ImperialSpaceSociety/Project-Mach-1/docs/README.md

# Project-Mach-1
# **docs - Top Level Specfications and Documents**

This is the design for the 2 stage rocket designed to pass the speed of sound. A hand drawing of the rocket is as shown:
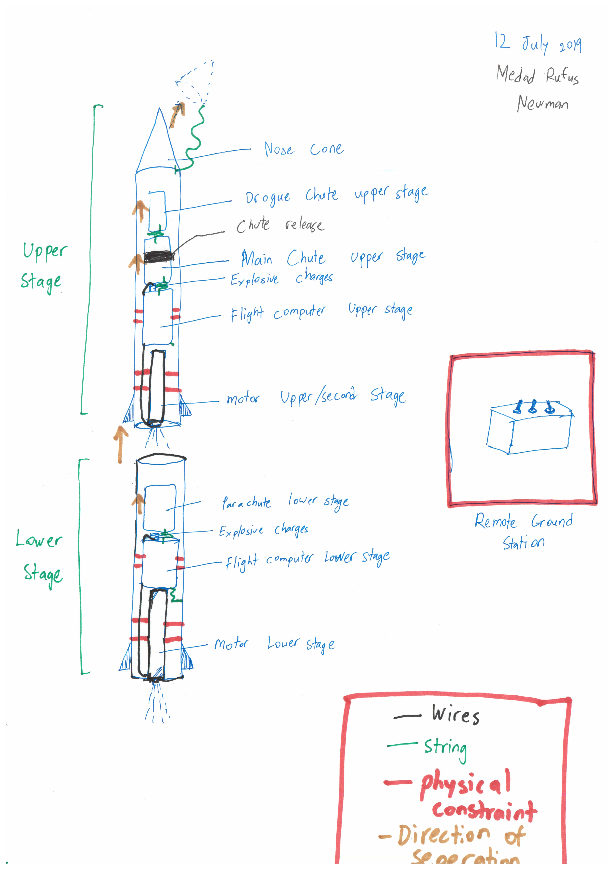
[picture p3: docs/rocket_drawing.jpg]
Hand drawing
