ImperialSpaceSociety/Project-Mach-1/Flight Computer V2.1/Gas sensors ideas.txt

https://www.sensirion.com/en/environmental-sensors/carbon-dioxide-sensors/carbon-dioxide-sensor-scd4x/
https://www.co2meter.com/collections/carbon-dioxide-sensors/products/lp8-miniature-co2-sensor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 This also works. It's very light. Has arduino stuff.
https://www.infineon.com/cms/en/product/sensor/co2-sensors/ //CO2 sensor, not sure if the 30 ppm accuracy is going to deliver meaningful data
