ImperialSpaceSociety/Project-Mach-1/Flight Computer V2.1/Pressure sensors ideas.txt

https://www.rapidonline.com/adafruit-1893-mpl3115a2-i2c-barometric-pressure-altitude-temperature-sensor-73-5402
https://www.adafruit.com/product/1603 //similar to the one above
https://www.mouser.co.uk/ProductDetail/Amphenol-All-Sensors/ELVH-030A-HNNJ-I-N2A4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
