ImperialSpaceSociety/Project-Mach-1/Flight Computer V2.1/Radio ideas.md

Ideas for radios here:

http://eggtimerrocketry.com/wp-content/uploads/2018/10/Eggfinder-Mini-Assembly-Manual-A7-Pics.pdf

use lora without datarate limitations (so not lorawan)

# SX1276/77/78/79 from Semtech

- Very common LoRA chip featured in many modules
- Link: https://www.semtech.com/products/wireless-rf/lora-core/sx1278

- Notable Features:
  - Programmable bit rate up to 300 Kbps
  - Low power consumption
  - Has Arduino libraries ready to use
  - Cheap: most modules are under 10 GBP.

  - http://en.ashining.com/

- Wide array of pre-built modules in many form factors:
  - https://item.taobao.com/item.htm?spm=a230r.1.14.61.c6207623p6iLYO&id=569473209313&ns=1&abbucket=16#detail
  - https://item.taobao.com/item.htm?spm=a230r.1.14.16.17807623d8OA8n&id=534906947976&ns=1&abbucket=16#detail
  - https://item.taobao.com/item.htm?spm=a230r.1.14.22.17807623d8OA8n&id=644570447285&ns=1&abbucket=16#detail
  - https://item.taobao.com/item.htm?spm=a230r.1.14.28.17807623d8OA8n&id=631724138123&ns=1&abbucket=16#detail
  - https://item.taobao.com/item.htm?spm=a230r.1.14.41.17807623d8OA8n&id=543372168003&ns=1&abbucket=16#detail
  - https://item.taobao.com/item.htm?spm=a230r.1.14.126.17807623d8OA8n&id=526364795844&ns=1&abbucket=16#detail

# HopeRF RFM95/98

- Link: https://www.hoperf.com/modules/lora/RFM95.html

# XBEE®868LP
- https://docs.rs-online.com/d0cc/0900766b8148f252.pdf

# XBP9B-XCST-021
- https://www.mouser.co.uk/ProductDetail/DIGI/XBP9B-XCST-021?qs=bzXpJip73srHwKnGuHrX3A%3D%3D
