ImperialSpaceSociety/Project-Mach-1/Flight Computer V2.1/Radios we have.md

- Ground station:
	https://eu.mouser.com/ProductDetail/DIGI/XBP9B-DPST-041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
	
	Datasheet: https://hub.digi.com/support/products/digi-xbee/digi-xbee-pro-900hp/
	
- Rocket:
	https://eu.mouser.com/ProductDetail/DIGI/XBP9XT-DMRS-001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
	
	Datasheet: https://www.digi.com/resources/documentation/Digidocs/90001476/Default.htm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
