ImperialSpaceSociety/Project-Mach-1/Flight Computer V2.1/XBEE comparison.PNG

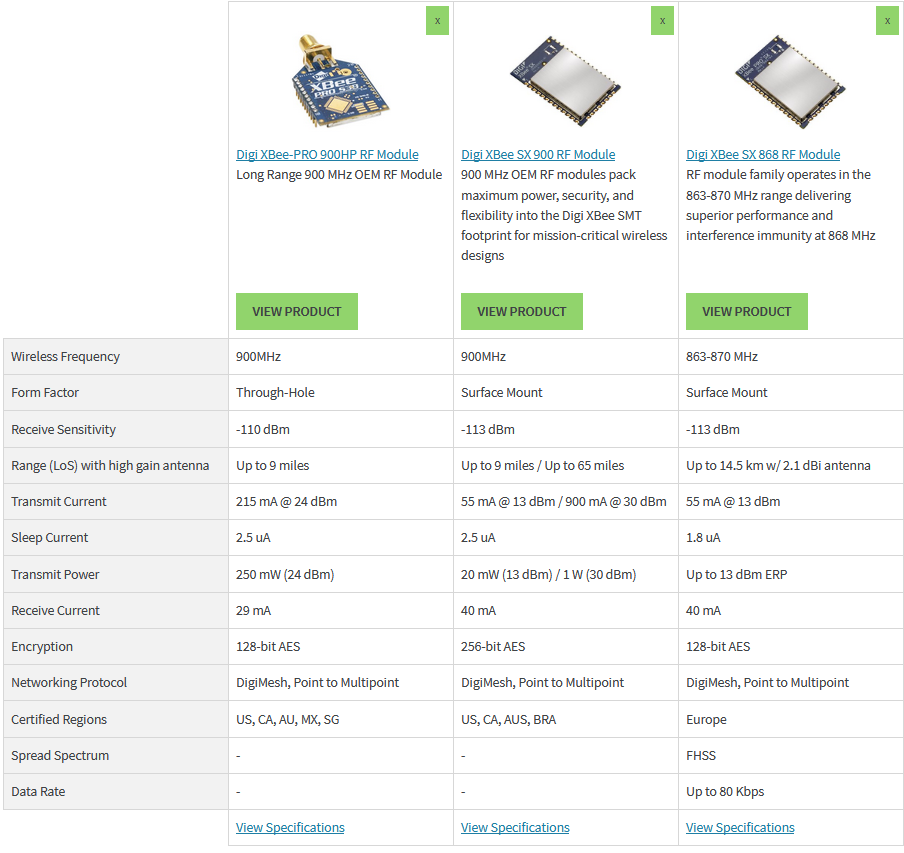
Flight Computer V2.1/XBEE comparison.PNG
