ImperialSpaceSociety/Project-Mach-1/Hardware/circuit board design v1.1/BOM v1.1.xlsx

Bill of materials for Project Mach 1, the high powered rocketry project at the Imperial College Space Society. The plan is to built 5 identical flight computers that can be used in a single stage rocket or a multi stage setup.
The flight computer has a size of
Components that go on the PCB
Reference | Value | Footprint | Datasheet | Unit cost | Purchase Link | Quantity per flight computer
ANT1 | Yageo434 | flight-computer:Yageo434 | https://www.mouser.co.uk/datasheet/2/447/An_SMD_UHF_433_1204_0-595178.pdf | £1.33 | https://www.mouser.co.uk/ProductDetail/Yageo/ANT1204F002R0433A | 1
BZ1 | Buzzer | Buzzer_Beeper:Buzzer_12x9.5RM7.6 | https://docs-emea.rs-online.com/webdocs/1581/0900766b815810c5.pdf | £1.05 | https://uk.rs-online.com/web/p/magnetic-buzzer-components/6173081/?searchTerm=6173081 | 1
> C8, C20, C34 | 10nF | Capacitor_SMD:C_0402_1005Metric | ~ |  |  | 3
C9 | 270pF | Capacitor_SMD:C_0402_1005Metric | ~ |  |  | 1
C19 | 270pf | Capacitor_SMD:C_0402_1005Metric | ~ |  |  | 1
C21 | 33nF | Capacitor_SMD:C_0402_1005Metric | ~ |  |  | 1
> C22, C35, C36, C90 | 1uF | Capacitor_SMD:C_0603_1608Metric | ~ |  |  | 4
> C30, C77 | 220nF | Capacitor_SMD:C_0603_1608Metric | ~ |  |  | 2
> C1, C2, C5, C12, C32, C92 | 10uF | Capacitor_SMD:C_0603_1608Metric | ~ |  |  | 6
> C3, C4, C6, C7, C11, C23, C28, C29, C31, C33, C89, C91, C93 | 100nF | Capacitor_SMD:C_0603_1608Metric | ~ |  |  | 13
> C86, C88 | 15pF | Capacitor_SMD:C_0402_1005Metric | ~ |  |  | 2
D1 | RED_LED | LED_SMD:LED_0603_1608Metric | ~ |  |  | 1
D2 | BLUE_LED | LED_SMD:LED_0603_1608Metric | ~ |  |  | 1
D3 | DFLS130L | Diode_SMD:D_PowerDI-123 | https://www.diodes.com/assets/Datasheets/ds30492.pdf | £0.45 | https://www.mouser.co.uk/ProductDetail/Diodes-Incorporated/DFLS130LQ-7 | 1
> H1-H4 | MountingHole_Pad | MountingHole:MountingHole_3.2mm_M3_Pad | ~ |  |  | 4
J1 | Conn_01x05 | Connector_PinHeader_2.54mm:PinHeader_1x05_P2.54mm_Vertical | ~ |  |  | 1
J2 | USB_B_Micro | flight-computer:USB_Micro-B_Molex-105017-0001 | https://www.molex.com/webdocs/datasheets/pdf/en-us/1050170001_IO_CONNECTORS.pdf | £0.64 | https://www.mouser.co.uk/ProductDetail/Molex/105017-0001 | 1
> J3, J5 | Screw_Terminal_01x04 | flight-computer:TerminalBlock_TE_282834-4_1x04_P2.54mm_Horizontal | ~ |  | https://www.mouser.co.uk/ProductDetail/TE-Connectivity/282834-4?qs=A%252Bip%252BNCYi6Pqom9P%2FaHyRQ== | 2
J4 | Conn_01x02 | Connector_JST:JST_PH_B2B-PH-K_1x02_P2.00mm_Vertical | https://docs-emea.rs-online.com/webdocs/1347/0900766b81347511.pdf | £0.38 | https://uk.rs-online.com/web/p/pcb-headers/8201422/ | 1
> J6, J7 | Conn_Coaxial | Connector_Coaxial:U.FL_Hirose_U.FL-R-SMT-1_Vertical | https://www.mouser.co.uk/datasheet/2/185/U.FL_catalog-939761.pdf | £1.05 | https://www.mouser.co.uk/ProductDetail/Hirose-Connector/UFL-R-SMT01?qs=Ux3WWAnHpjDV3tCCbDi65g== | 2
L1 | L_Core_Ferrite | Inductor_SMD:L_0603_1608Metric | ~ |  |  | 1
L2 | 27nH | Resistor_SMD:R_0402_1005Metric | ~ |  |  | 1
L3 | 0R | Inductor_SMD:L_0402_1005Metric | ~ |  |  | 1
L8 | 220nH | Inductor_SMD:L_0603_1608Metric | ~ |  |  | 1
R2 | 10 Ohm | Resistor_SMD:R_0402_1005Metric | ~ |  |  | 1
> C10, R7 | NF | ... | ~ |  |  | 2
> R1, R12, R25, R26 | 1K | Resistor_SMD:R_0603_1608Metric | ~ |  |  | 4
> R3, R13, R17, R18 | 3.3K | Resistor_SMD:R_0603_1608Metric | ~ |  |  | 4
> R6, R16, R23, R24 | 27K | Resistor_SMD:R_0603_1608Metric | ~ |  |  | 4
> R5, R15, R21, R22, R28, R29 | 100K | Resistor_SMD:R_0603_1608Metric | ~ |  |  | 6
U1 | IIS2MDC | Package_LGA:LGA-12_2x2mm_P0.5mm | https://www.mouser.co.uk/datasheet/2/389/iis2mdc-1309412.pdf | £1.93 | https://www.mouser.co.uk/ProductDetail/STMicroelectronics/IIS2MDCTR | 1
U2 | 0433BM41A0019E | Johanson_frontend:BALUN_0433BM41A0019E | https://www.johansontechnology.com/datasheets/0433BM41A0019/0433BM41A0019.pdf | £0.74 | https://www.mouser.co.uk/ProductDetail/Johanson-Technology/0433BM41A0019E?qs=cgWa3jCOTNkHeQmiwnsqmQ== | 1
U3 | Si4463 | Package_DFN_QFN:QFN-20-1EP_4x4mm_P0.5mm_EP2.6x2.6mm_ThermalVias | https://www.silabs.com/documents/public/data-sheets/Si4464-63-61-60.pdf | £2.28 | https://www.mouser.co.uk/ProductDetail/Silicon-Labs/SI4463-C2A-GM | 1
U4 | MAX-M8C | RF_GPS:ublox_MAX | https://www.u-blox.com/sites/default/files/MAX-M8-FW3_DataSheet_%28UBX-15031506%29.pdf | £11.99 | https://store.uputronics.com/index.php?route=product/product&product_id=71&search=ublox | 1
> U5, U6 | Si7232DN | Package_SO:Vishay_PowerPAK_1212-8_Dual | https://www.vishay.com/docs/68986/si7232dn.pdf | £0.73 | https://www.mouser.co.uk/ProductDetail/Vishay-Siliconix/SI7232DN-T1-GE3?qs=%252BPu8jn5UVnH5FJ8Jo4EbFw%3D%3D | 2
U8 | MS5607-02BA | Package_LGA:LGA-8_3x5mm_P1.25mm | https://www.te.com/commerce/DocumentDelivery/DDEController?Action=showdoc | £2.42 | https://www.mouser.co.uk/ProductDetail/Measurement-Specialties/MS560702BA03-50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 | 1
U9 | STF202-22T1G | Package_SO:TSOP-6_1.65x3.05mm_P0.95mm | https://www.onsemi.com/pub/Collateral/STF202-22T1-D.PDF | £0.47 | https://www.mouser.co.uk/ProductDetail/ON-Semiconductor/STF202-22T1G | 1
U10 | BMI088 | BMI088:PQFN50P450X300X100-16N | https://ae-bst.resource.bosch.com/media/_tech/media/datasheets/BST-BMI088-DS001.pdf | £5.21 | https://www.mouser.co.uk/ProductDetail/Bosch-Sensortec/BMI088?qs=f9yNj16SXrIMFspTV6RB6Q%3D%3D | 1
U11 | ATSAML21J18B-AUT | Package_QFP:TQFP-64_10x10mm_P0.5mm | http://ww1.microchip.com/downloads/en/DeviceDoc/60001477A.pdf | £4.15 | https://www.mouser.co.uk/ProductDetail/Microchip-Technology/ATSAML21J18B-AUT?qs=RCSZh%2F2c5ne9n8KccuU8Bw%3D%3D | 1
U14 | MAX40200AUK | Package_TO_SOT_SMD:SOT-23-5 | https://datasheets.maximintegrated.com/en/ds/MAX40200.pdf | £0.73 | https://www.mouser.co.uk/ProductDetail/Maxim-Integrated/MAX40200AUK%2bT | 1
U15 | LD3985G33R_TSOT23 | Package_TO_SOT_SMD:TSOT-23-5 | http://www.st.com/internet/com/TECHNICAL_RESOURCES/TECHNICAL_LITERATURE/DATASHEET/CD00003395.pdf | £0.48 | https://www.mouser.co.uk/ProductDetail/STMicroelectronics/LD3985M25R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 | 1
U? | W25Q64JVSSIM | Package_SO:SOIC-8_5.23x5.23mm_P1.27mm | https://docs-emea.rs-online.com/webdocs/1703/0900766b81703f87.pdf | £0.72 | https://uk.rs-online.com/web/p/flash-memory/1882666/ | 1
X1 | TM-32.000-AF3-33-S-Oscillator | Crystal:Crystal_SMD_2520-4Pin_2.5x2.0mm | https://docs-emea.rs-online.com/webdocs/15dc/0900766b815dc7d9.pdf | £3.43 | https://uk.rs-online.com/web/p/tcxo-oscillators/1442366/ | 1
Y3 | 16MHz | flight-computer:Crystal_SMD_2520-4Pin_2.5x2.0mm | https://docs-emea.rs-online.com/webdocs/15dc/0900766b815dc75d.pdf | £0.65 | https://uk.rs-online.com/web/p/crystal-units/1442292/ | 1
External components
Active GPS antenna | 2066400001 |  | https://www.mouser.co.uk/datasheet/2/276/2066400001_ANTENNAS-1365525.pdf | £5.30 | https://www.mouser.co.uk/ProductDetail/Molex/206640-0001 | 1
Fixed costs(one off purchase)
Item | Part number | Description |  | Unit cost | Purchase link | Quantity needed
Custom Printed Circuit Board |  | custom circuit boards and stensils |  | £48.80 | https://jlcpcb.com/quote | 1
SEGGER J-Link EDU Debugging Emulator | 131-1323 | programmer for microcontrollers |  | £62.68 | https://uk.rs-online.com/web/p/products/1311323 | 1
Mouser delivery |  | Delivery cost for mouser components |  | £12.00
Total costs
 |  | There will be 5 flight computers built because the minimum order for PCBs is 5. This means that all components are ordered in fives
 |  | I also include the one time cost of making the PCBs and the programmer
 |  | Total cost: | £452.00
 |  |  |  |  |  |  | 26.5
 |  |  |  |  |  |  | 26.5
 |  |  |  |  |  |  | 75.3
