ImperialSpaceSociety/Project-Mach-1/Hardware/circuit board design/MAX (STEP-AP203).STEP

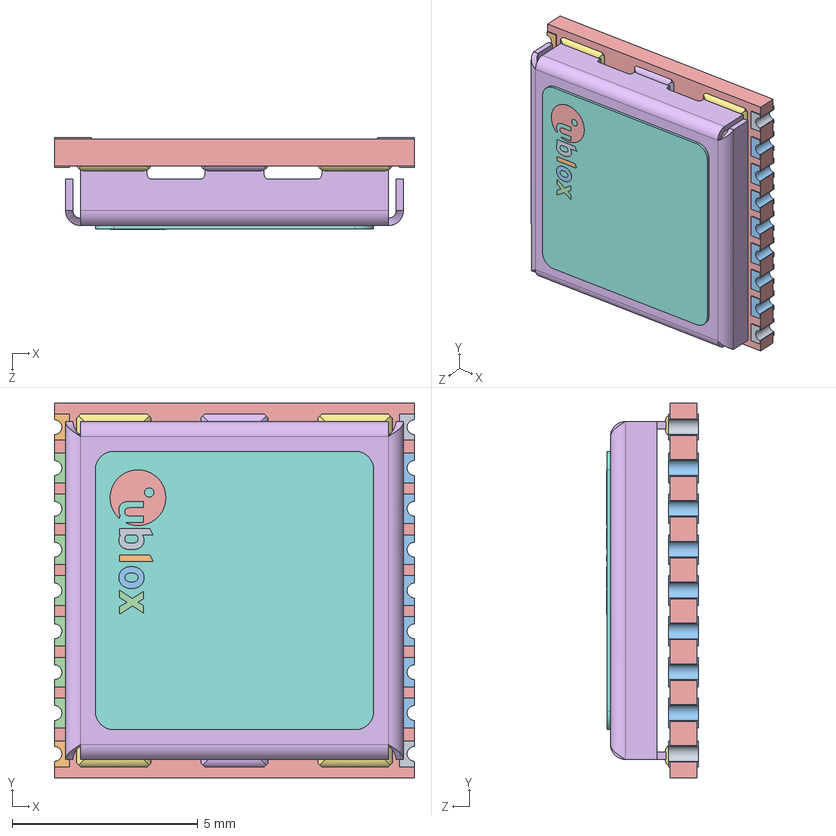
[picture p13: CAD file, 2019-09-06, an earlier design]
Hardware/circuit board design/MAX (STEP-AP203).STEP
9.70 x 10.1 x 2.47 mm
MAX_PCB
u-blox_MAX_label_Default
Shield
