ImperialSpaceSociety/Project-Mach-1/(threads)

Thread 16 (2021-06-18):

SPI flash chip not responding

MedadRufus, 2021-06-18:
Log from arduino program:

```

Initialising..........

SPIMemory Library version: < 2.5.0

No comms. Check wiring. Is chip supported? If unable to fix, raise an issue on Github

```

MedadRufus, 2021-06-18:
The flash chip may have been damaged as Adam found out.

MedadRufus, 2021-06-18:
Go to uni and collect another flash chip if there is one there.

Closed 2021-06-22.

Thread 19 (2021-06-21):

MS5607 is not reporting values

MedadRufus, 2021-06-21:
But the LSM9DS1 is reporting

MedadRufus, 2021-06-21:
```
accelerate of x, y, z = -0.61g	-0.50g	-0.42g
Temperature [0.01 C]: ovfPressure [Pa]: ovf
Gyro: 1.31, 2.89, 0.37 deg/s
Acceleration: -15.02, -7.66, -145.01 g
Mag: -53.79, 6.50, -9.80 gauss
GPS info: 0, 0, 0
```

MedadRufus, 2021-06-21:
Issue with h3lis fixed; it was using wrong i2c address in library.

MedadRufus, 2021-06-21:
example code for the ms5607 works OK.

Closed 2021-06-22.

Thread 31 (2021-06-25):

remove all delays and replace with mydelayms

MedadRufus, 2021-06-25:
All delay are blocking on the SAMD, unlink on the ESP32

Thread 35 (2021-06-25):

Consider datacorruption with unstable power supply.

MedadRufus, 2021-06-25:
Flush every 0.5 second. Should be safe then I think
