ImperialSpaceSociety/Project-Mach-1/Hardware/circuit board design/circuit board design.kicad_pcb

## KiCad design Hardware/circuit board design/circuit board design.kicad_pcb (2019-09-18, an earlier design)

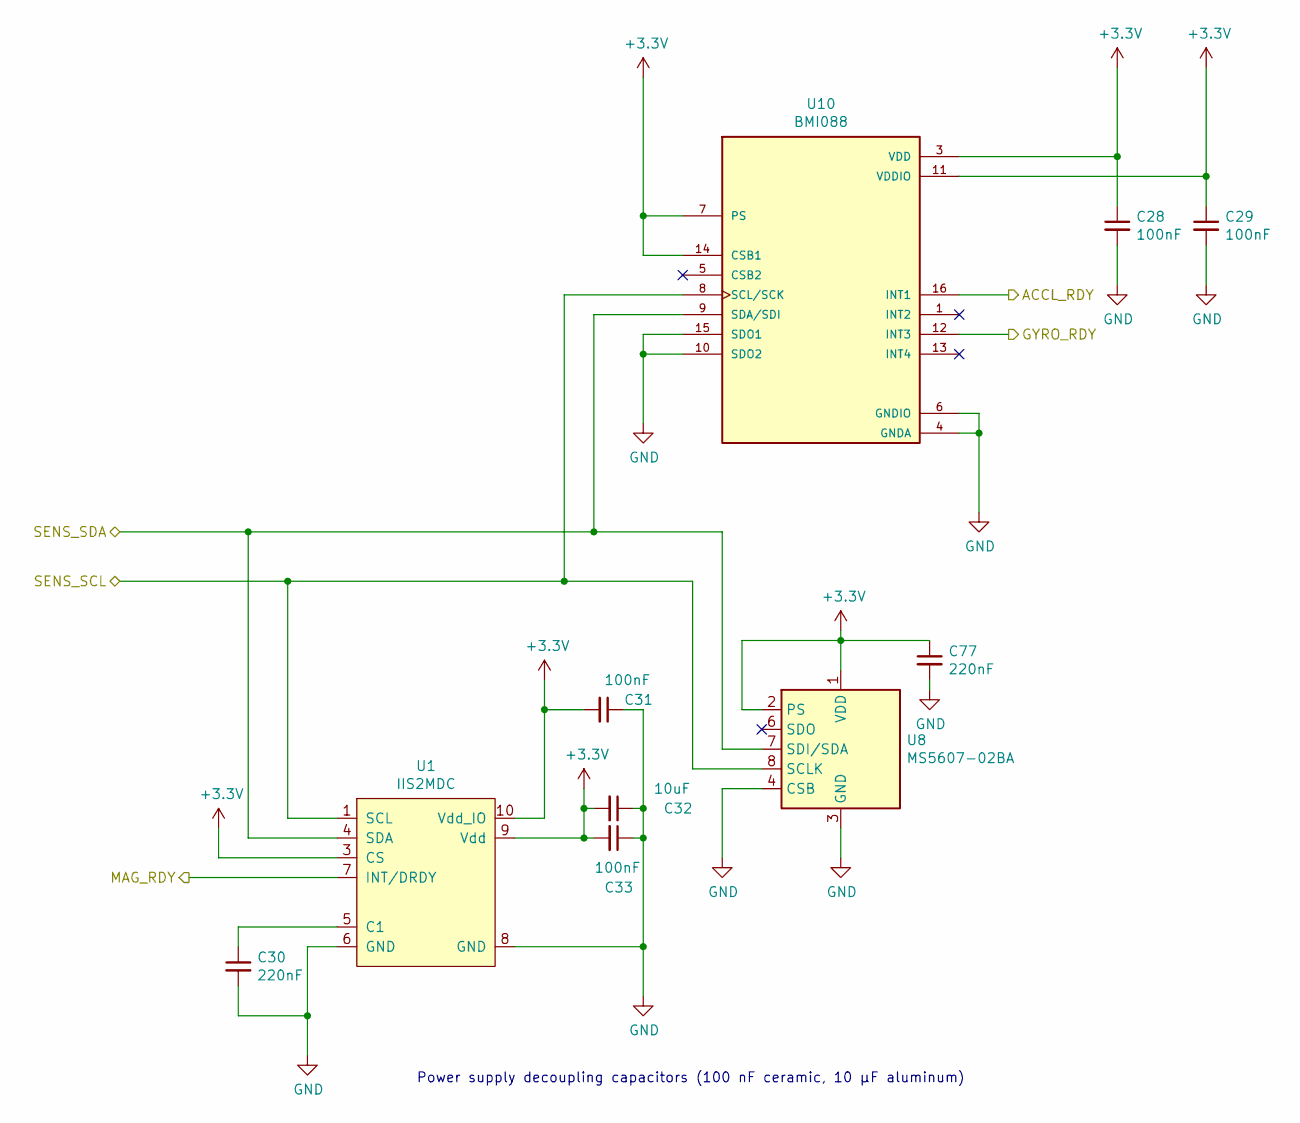
[picture p21: schematic sensors.sch]

Parts:
C28, C29, C31, C33: 100nF; C_0603_1608Metric
C30, C77: 220nF; C_0603_1608Metric
C32: 10uF; C_0603_1608Metric
U1: IIS2MDC; LGA-12_2x2mm_P0.5mm
U8: MS5607-02BA; LGA-8_3x5mm_P1.25mm
U10: BMI088; PQFN50P450X300X100-16N

Connections:
+3V3: C28.1, C29.1, C31.2, C32.2, C33.2, C77.1, U1.3 (CS), U1.9 (Vdd), U1.10 (Vdd_IO), U8.1 (VDD), U8.2 (PS), U10.3 (VDD), U10.7 (PS), U10.11 (VDDIO), U10.14 (CSB1); also elsewhere on the board
/gps/GPS_SCL: U1.1 (SCL), U8.8 (SCLK), U10.8 (SCL/SCK); also elsewhere on the board
/gps/GPS_SDA: U1.4 (SDA), U8.7 (SDI/SDA), U10.9 (SDA/SDI); also elsewhere on the board
/sensors/ACCL_RDY: U10.16 (INT1); also elsewhere on the board
/sensors/GYRO_RDY: U10.12 (INT3); also elsewhere on the board
/sensors/MAG_RDY: U1.7 (INT/DRDY); also elsewhere on the board
GND: C28.2, C29.2, C30.2, C31.1, C32.1, C33.1, C77.2, U1.6 (GND), U1.8 (GND), U8.3 (GND), U8.4 (CSB), U8.5 (CSB), U10.4 (GNDA), U10.6 (GNDIO), U10.10 (SDO2), U10.15 (SDO1); also elsewhere on the board
unnamed: C30.1, U1.5 (C1)

Notes on the sheet:
Power supply decoupling capacitors (100 nF ceramic, 10 μF aluminum)

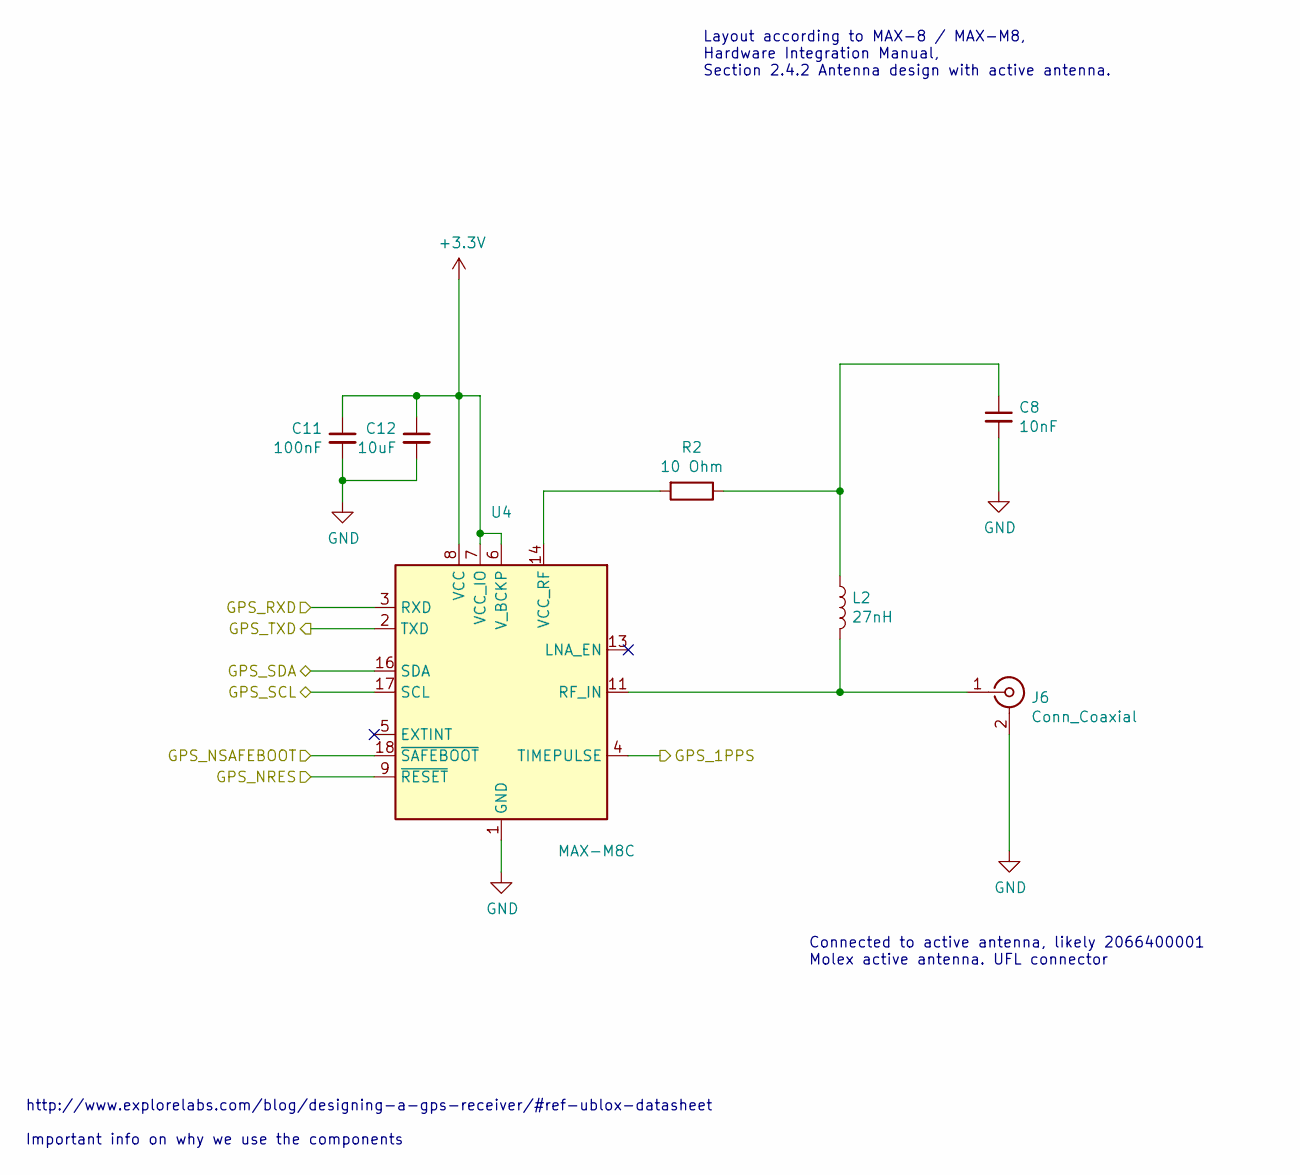
[picture p22: schematic GPS.sch]

Parts:
C8: 10nF; C_0402_1005Metric
C11: 100nF; C_0603_1608Metric
C12: 10uF; C_0603_1608Metric
J6: Conn_Coaxial; U.FL_Hirose_U.FL-R-SMT-1_Vertical
L2: 27nH; R_0402_1005Metric
R2: 10 Ohm; R_0402_1005Metric
U4: MAX-M8C; ublox_MAX

Connections:
+3V3: C11.1, C12.1, U4.6 (V_BCKP), U4.7 (VCC_IO), U4.8 (VCC); also elsewhere on the board
/MCU/GPS_RXD0: U4.2 (TXD); also elsewhere on the board
/gps/GPS_1PPS: U4.4 (TIMEPULSE); also elsewhere on the board
/gps/GPS_NRES: U4.9 (~RESET); also elsewhere on the board
/gps/GPS_NSAFEBOOT: U4.18 (~SAFEBOOT); also elsewhere on the board
/gps/GPS_RXD: U4.3 (RXD); also elsewhere on the board
/gps/GPS_SCL: U4.17 (SCL); also elsewhere on the board
/gps/GPS_SDA: U4.16 (SDA); also elsewhere on the board
GND: C8.2, C11.2, C12.2, J6.2 (Ext), U4.1 (GND), U4.10 (GND), U4.12 (GND); also elsewhere on the board
unnamed: C8.1, L2.1, R2.1
unnamed: J6.1 (In), L2.2, U4.11 (RF_IN)
unnamed: R2.2, U4.14 (VCC_RF)

Notes on the sheet:
http://www.explorelabs.com/blog/designing-a-gps-receiver/#ref-ublox-datasheet Important info on why we use the components
Connected to active antenna, likely 2066400001 Molex active antenna. UFL connector
Layout according to MAX-8 / MAX-M8, Hardware Integration Manual, Section 2.4.2 Antenna design with active antenna.

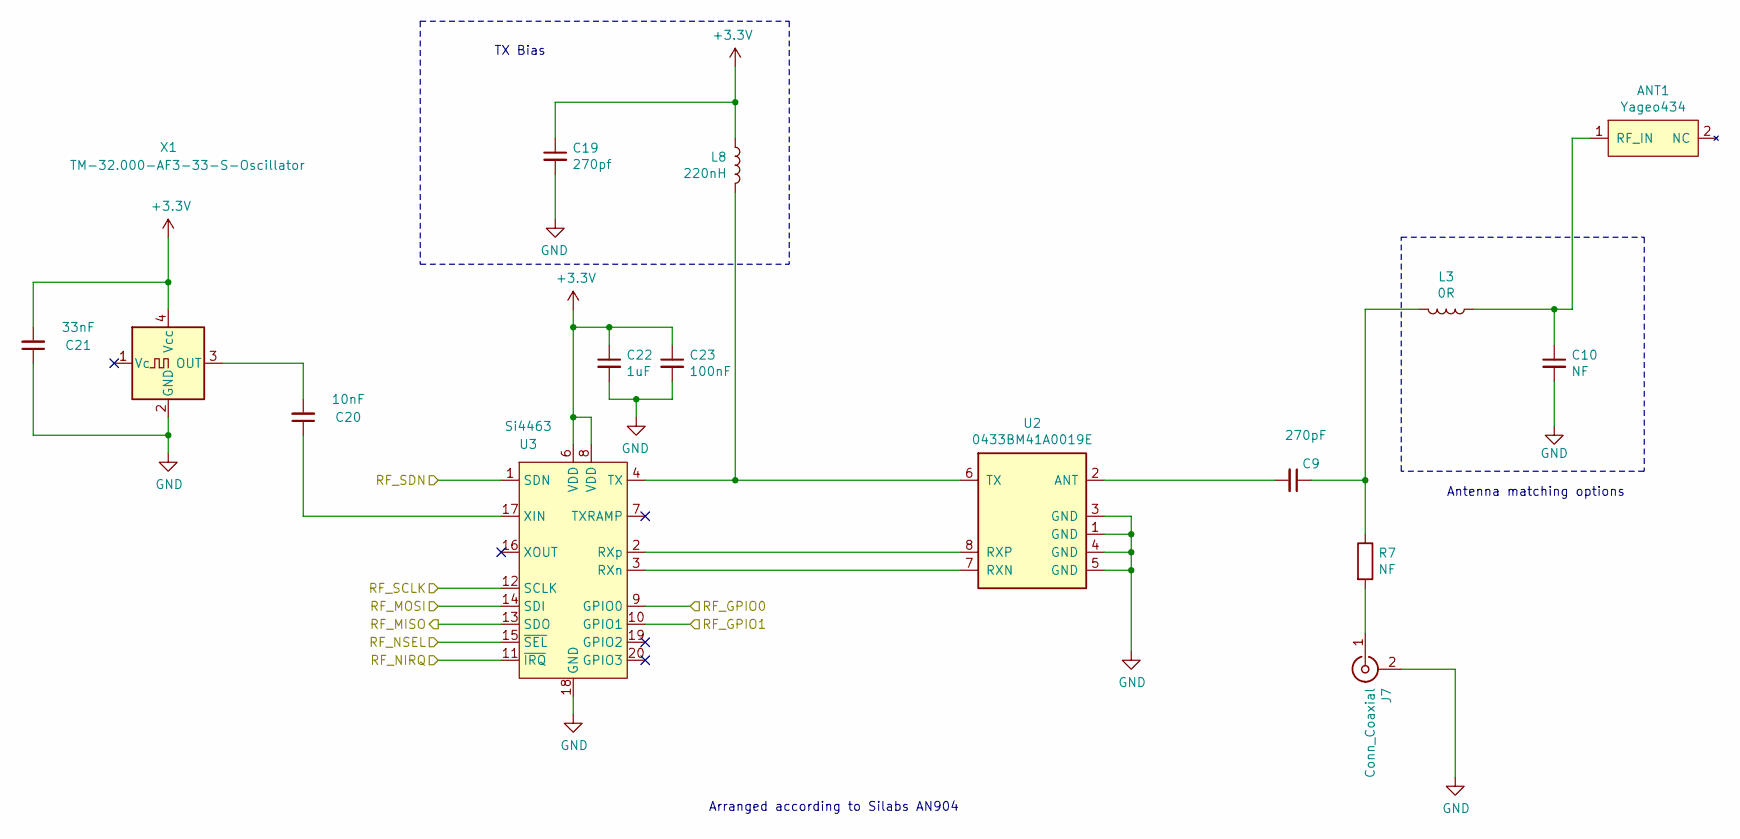
[picture p23: schematic telemetry_radio.sch, Silabs radio chip for telemetry to ground]

Parts:
ANT1: Yageo434
C9: 270pF; C_0402_1005Metric
C10: NF; C_0402_1005Metric
C19: 270pf; C_0402_1005Metric
C20: 10nF; C_0402_1005Metric
C21: 33nF; C_0402_1005Metric
C22: 1uF; C_0603_1608Metric
C23: 100nF; C_0603_1608Metric
J7: Conn_Coaxial; U.FL_Hirose_U.FL-R-SMT-1_Vertical
L3: 0R; L_0402_1005Metric
L8: 220nH; L_0603_1608Metric
R7: NF; R_0402_1005Metric
U2: 0433BM41A0019E; BALUN_0433BM41A0019E
U3: Si4463; QFN-20-1EP_4x4mm_P0.5mm_EP2.6x2.6mm_ThermalVias
X1: TM-32.000-AF3-33-S-Oscillator; Crystal_SMD_2520-4Pin_2.5x2.0mm

Connections:
+3V3: C19.1, C21.2, C22.1, C23.1, L8.2, U3.6 (VDD), U3.8 (VDD), X1.4 (Vcc); also elsewhere on the board
/MCU/MCU_MISO1: U3.13 (SDO); also elsewhere on the board
/MCU/MCU_MOSI1: U3.14 (SDI); also elsewhere on the board
/MCU/MCU_NSEL1: U3.15 (~SEL); also elsewhere on the board
/MCU/MCU_PA12: U3.10 (GPIO1); also elsewhere on the board
/MCU/MCU_PA13: U3.9 (GPIO0); also elsewhere on the board
/MCU/MCU_PB10: U3.11 (~IRQ); also elsewhere on the board
/MCU/MCU_PB11: U3.1 (SDN); also elsewhere on the board
/MCU/MCU_SCLK1: U3.12 (SCLK); also elsewhere on the board
GND: C10.2, C19.2, C21.1, C22.2, C23.2, J7.2 (Ext), U2.1 (GND), U2.3 (GND), U2.4 (GND), U2.5 (GND), U3.18 (GND), U3.21 (GND), X1.2 (GND); also elsewhere on the board
unnamed: ANT1.1 (RF_IN), C10.1, L3.1
unnamed: C9.1, L3.2, R7.1
unnamed: C9.2, U2.2 (ANT)
unnamed: C20.1, U3.17 (XIN)
unnamed: C20.2, X1.3 (OUT)
unnamed: J7.1 (In), R7.2
unnamed: L8.1, U2.6 (TX), U3.4 (TX)
unnamed: U2.7 (RXN), U3.3 (RXn)
unnamed: U2.8 (RXP), U3.2 (RXp)

Notes on the sheet:
TX Bias
Arranged according to Silabs AN904
Antenna matching options

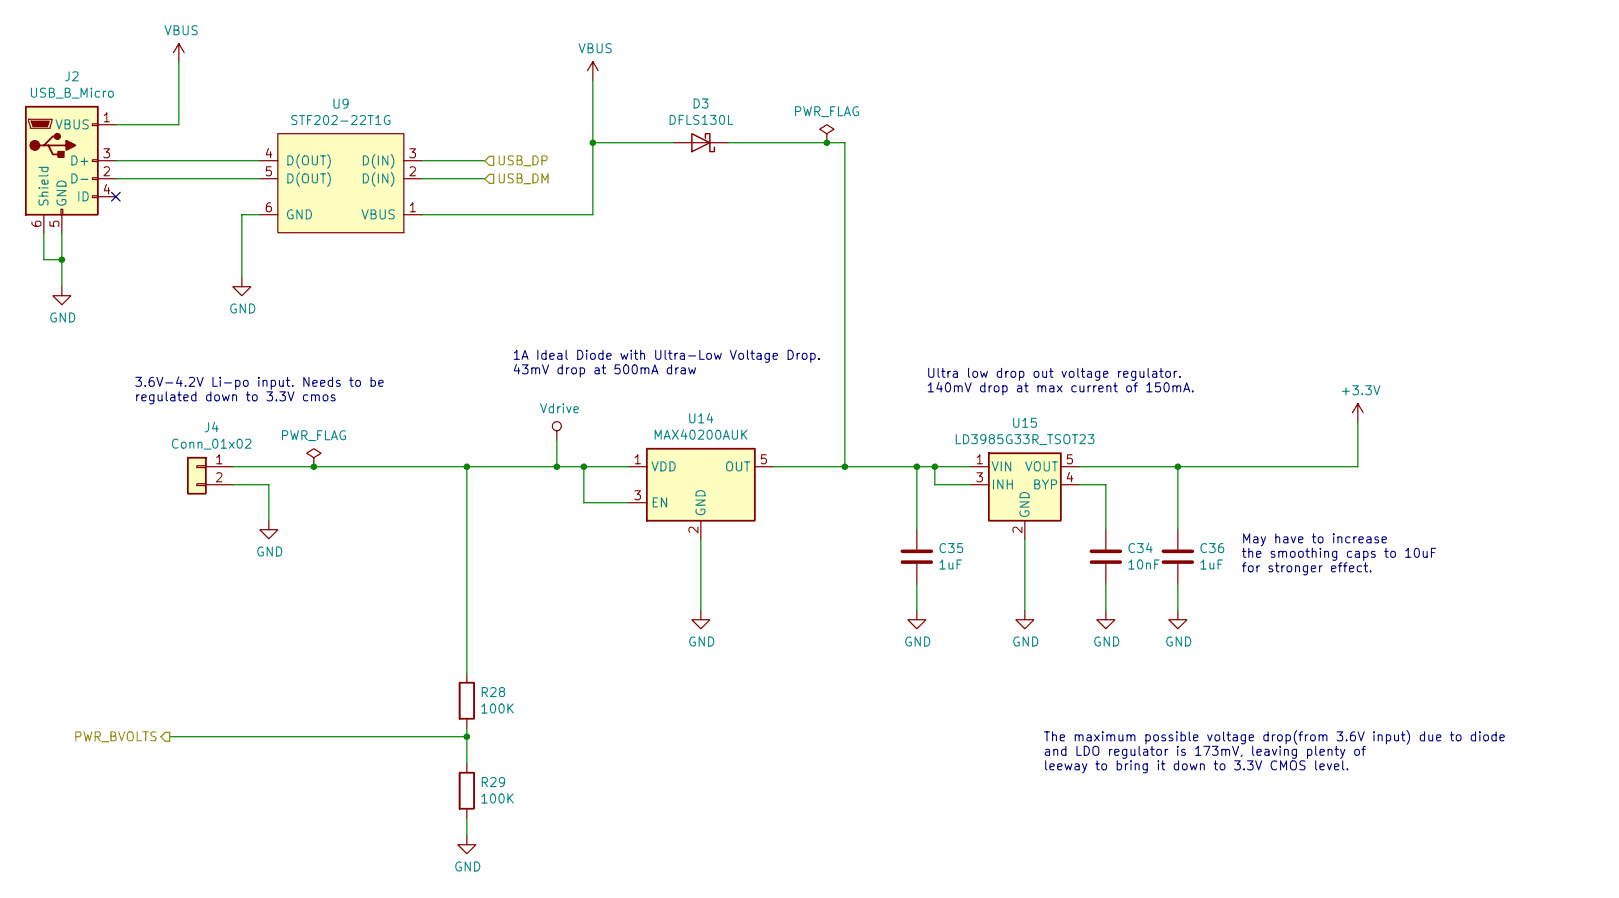
[picture p24: schematic power_supply.sch]

Parts:
C34: 10nF; C_0402_1005Metric
C35, C36: 1uF; C_0603_1608Metric
D3: DFLS130L; D_PowerDI-123
J2: USB_B_Micro; USB_Micro-B_Molex-105017-0001
J4: Conn_01x02; JST_PH_B2B-PH-K_1x02_P2.00mm_Vertical
R28, R29: 100K; R_0603_1608Metric
U9: STF202-22T1G; TSOP-6_1.65x3.05mm_P0.95mm
U14: MAX40200AUK; SOT-23-5
U15: LD3985G33R_TSOT23; TSOT-23-5

Connections:
+3V3: C36.1, U15.5 (VOUT); also elsewhere on the board
/MCU/MCU_PB08: R28.2, R29.1; also elsewhere on the board
/MCU/USB_DM: U9.3 (D(IN)); also elsewhere on the board
/power_supply/USB_DM: U9.2 (D(IN)); also elsewhere on the board
GND: C34.2, C35.2, C36.2, J2.5 (GND), J2.6 (Shield), J4.2, R29.2, U9.6 (GND), U14.2 (GND), U15.2 (GND); also elsewhere on the board
unnamed: C34.1, U15.4 (BYP)
unnamed: C35.1, D3.1 (K), U14.5 (OUT), U15.1 (VIN), U15.3 (INH)
unnamed: J2.2 (D-), U9.5 (D(OUT))
unnamed: J2.3 (D+), U9.4 (D(OUT))
VBUS: D3.2 (A), J2.1 (VBUS), U9.1 (VBUS)
Vdrive: J4.1, R28.1, U14.1 (VDD), U14.3 (EN); also elsewhere on the board

Notes on the sheet:
1A Ideal Diode with Ultra-Low Voltage Drop. 43mV drop at 500mA draw
May have to increase the smoothing caps to 10uF for stronger effect.
3.6V-4.2V Li-po input. Needs to be regulated down to 3.3V cmos
Ultra low drop out voltage regulator. 140mV drop at max current of 150mA.
The maximum possible voltage drop(from 3.6V input) due to diode and LDO regulator is 173mV, leaving plenty of leeway to bring it down to 3.3V CMOS level.

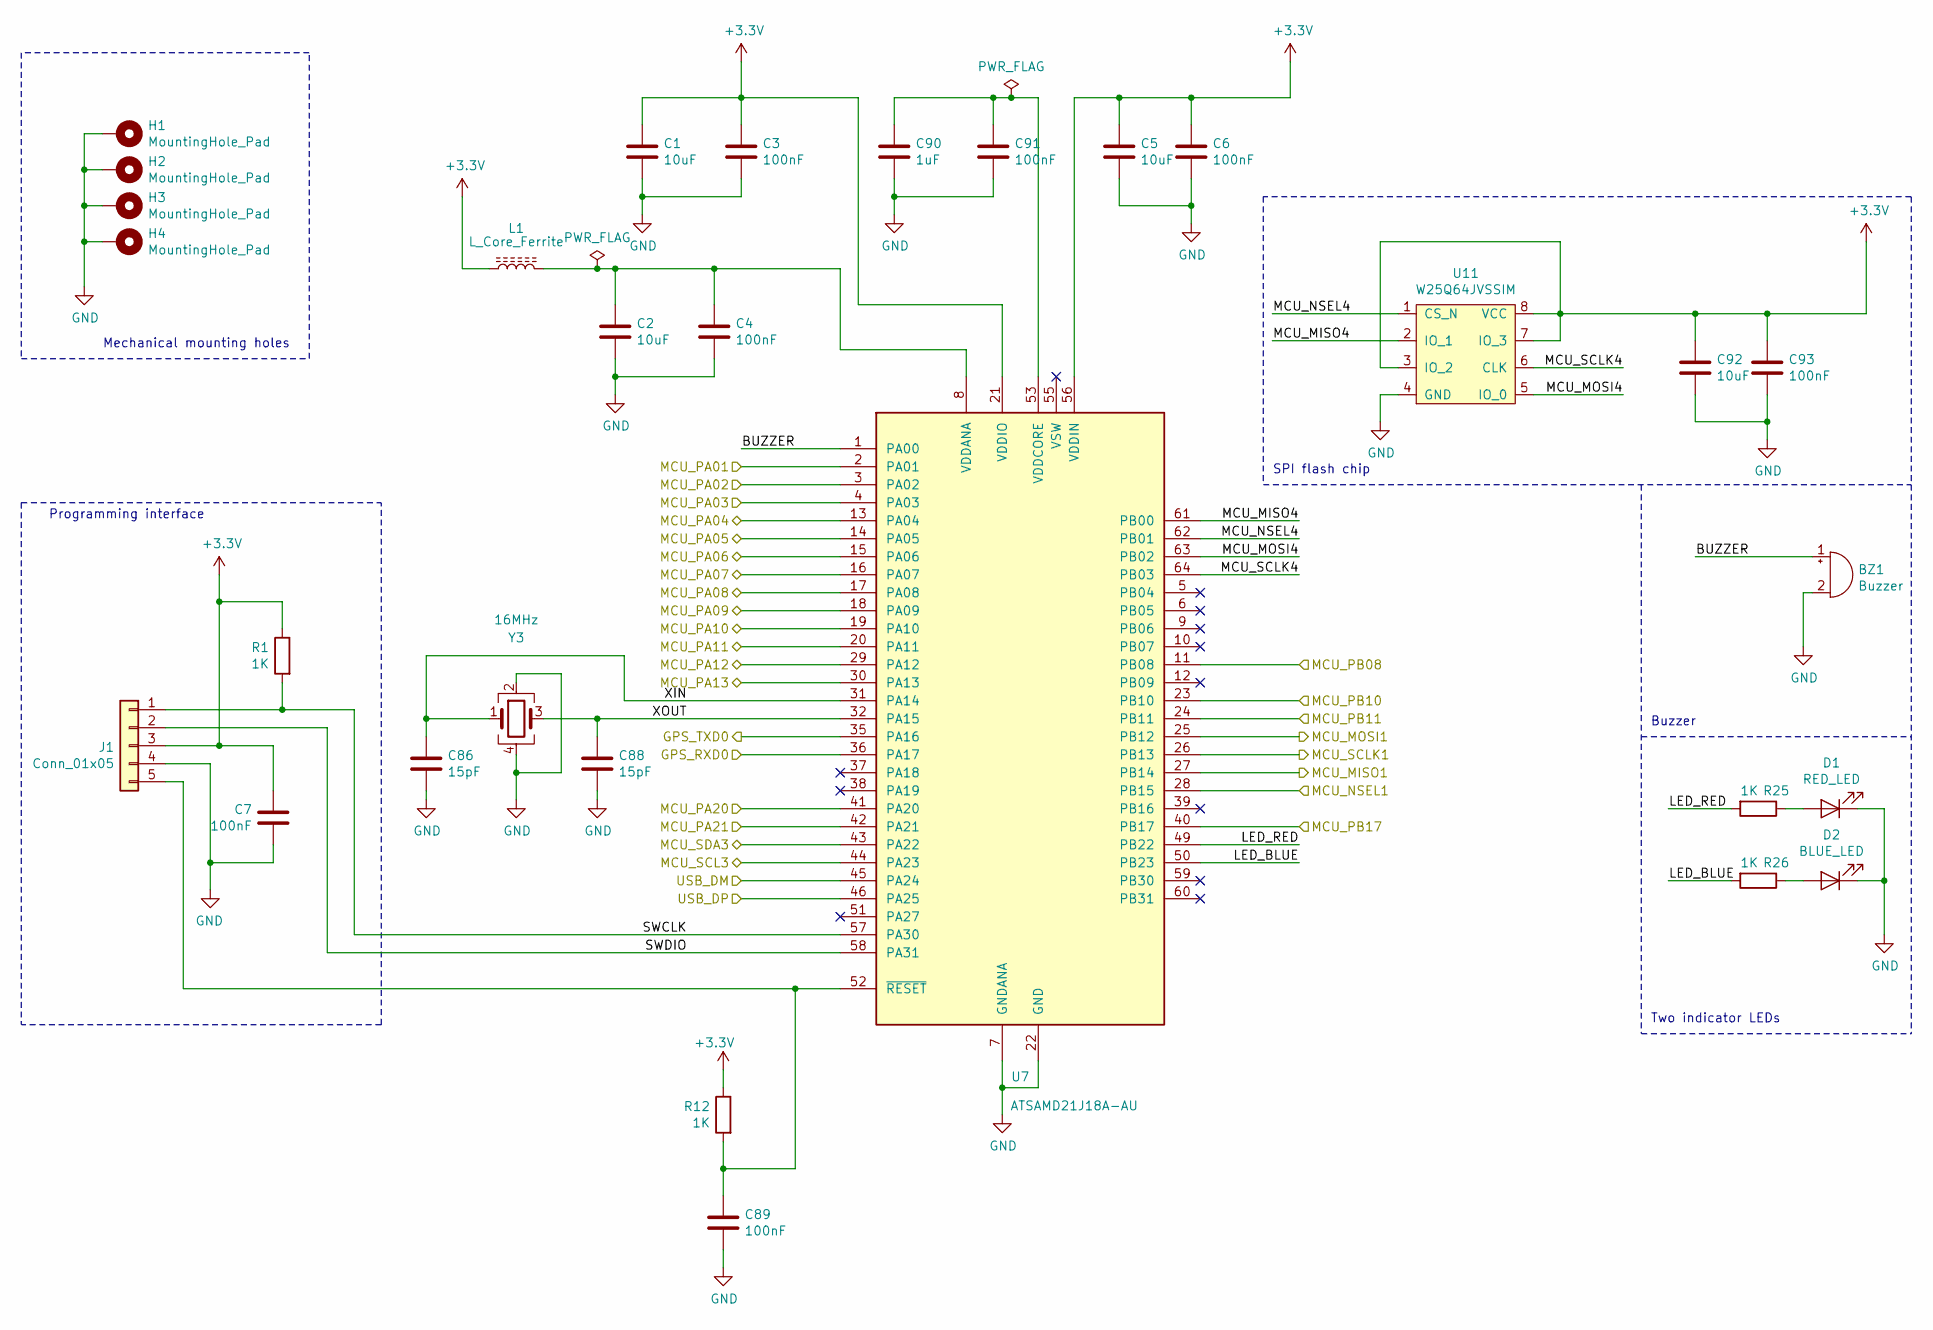
[picture p25: schematic MCU.sch]

Parts:
BZ1: Buzzer; Buzzer_12x9.5RM7.6
C1, C2, C5, C92: 10uF; C_0603_1608Metric
C3, C4, C6, C7, C89, C91, C93: 100nF; C_0603_1608Metric
C86, C88: 15pF; C_0402_1005Metric
C90: 1uF; C_0603_1608Metric
D1: RED_LED; LED_0603_1608Metric
D2: BLUE_LED; LED_0603_1608Metric
H1, H2, H3, H4: MountingHole_Pad; MountingHole_3.2mm_M3_Pad
J1: Conn_01x05; PinHeader_1x05_P2.54mm_Vertical
L1: L_Core_Ferrite; L_0603_1608Metric
R1, R12, R25, R26: 1K; R_0603_1608Metric
U7: ATSAMD21J18A-AU; TQFP-64_10x10mm_P0.5mm
U11: W25Q64JVSSIM; SOIC-8_5.23x5.23mm_P1.27mm
Y3: 16MHz; Crystal_SMD_2520-4Pin_2.5x2.0mm

Connections:
+3V3: C1.1, C3.1, C5.1, C6.1, C7.1, C92.1, C93.1, J1.3, L1.1, R1.1, R12.1, U7.21 (VDDIO), U7.34 (VDDIO), U7.48 (VDDIO), U7.56 (VDDIN), U11.3 (IO_2), U11.7 (IO_3), U11.8 (VCC); also elsewhere on the board
/MCU/BUZZER: BZ1.1 (-), U7.1 (PA00)
/MCU/GPS_RXD0: U7.36 (PA17); also elsewhere on the board
/MCU/LED_BLUE: R26.2, U7.50 (PB23)
/MCU/LED_RED: R25.2, U7.49 (PB22)
/MCU/MCU_MISO1: U7.27 (PB14); also elsewhere on the board
/MCU/MCU_MISO4: U7.61 (PB00), U11.2 (IO_1)
/MCU/MCU_MOSI1: U7.25 (PB12); also elsewhere on the board
/MCU/MCU_MOSI4: U7.63 (PB02), U11.5 (IO_0)
/MCU/MCU_NSEL1: U7.28 (PB15); also elsewhere on the board
/MCU/MCU_NSEL4: U7.62 (PB01), U11.1 (CS_N)
/MCU/MCU_PA04: U7.13 (PA04); also elsewhere on the board
/MCU/MCU_PA05: U7.14 (PA05); also elsewhere on the board
/MCU/MCU_PA06: U7.15 (PA06); also elsewhere on the board
/MCU/MCU_PA07: U7.16 (PA07); also elsewhere on the board
/MCU/MCU_PA12: U7.29 (PA12); also elsewhere on the board
/MCU/MCU_PA13: U7.30 (PA13); also elsewhere on the board
/MCU/MCU_PB08: U7.11 (PB08); also elsewhere on the board
/MCU/MCU_PB10: U7.23 (PB10); also elsewhere on the board
/MCU/MCU_PB11: U7.24 (PB11); also elsewhere on the board
/MCU/MCU_SCLK1: U7.26 (PB13); also elsewhere on the board
/MCU/MCU_SCLK4: U7.64 (PB03), U11.6 (CLK)
/MCU/SWCLK: J1.1, R1.2, U7.57 (PA30)
/MCU/SWDIO: J1.2, U7.58 (PA31)
/MCU/USB_DM: U7.45 (PA24); also elsewhere on the board
/MCU/XIN: C86.1, U7.31 (PA14), Y3.1
/MCU/XOUT: C88.1, U7.32 (PA15), Y3.3
/gps/GPS_1PPS: U7.3 (PA02); also elsewhere on the board
/gps/GPS_NRES: U7.4 (PA03); also elsewhere on the board
/gps/GPS_NSAFEBOOT: U7.2 (PA01); also elsewhere on the board
/gps/GPS_RXD: U7.35 (PA16); also elsewhere on the board
/gps/GPS_SCL: U7.44 (PA23); also elsewhere on the board
/gps/GPS_SDA: U7.43 (PA22); also elsewhere on the board
/power_supply/USB_DM: U7.46 (PA25); also elsewhere on the board
/pyro_driver/FIRE_A: U7.19 (PA10); also elsewhere on the board
/pyro_driver/FIRE_B: U7.20 (PA11); also elsewhere on the board
/pyro_driver/FIRE_C: U7.17 (PA08); also elsewhere on the board
/pyro_driver/FIRE_D: U7.18 (PA09); also elsewhere on the board
/sensors/ACCL_RDY: U7.41 (PA20); also elsewhere on the board
/sensors/GYRO_RDY: U7.42 (PA21); also elsewhere on the board
/sensors/MAG_RDY: U7.40 (PB17); also elsewhere on the board
GND: BZ1.2 (+), C1.2, C2.2, C3.2, C4.2, C5.2, C6.2, C7.2, C86.2, C88.2, C89.2, C90.2, C91.2, C92.2, C93.2, D1.1 (K), D2.1 (K), H1.1, H2.1, H3.1, H4.1, J1.4, U7.7 (GNDANA), U7.22 (GND), U7.33 (GND), U7.47 (GND), U7.54 (GND), U11.4 (GND), Y3.2, Y3.4; also elsewhere on the board
unnamed: C2.1, C4.1, L1.2, U7.8 (VDDANA)
unnamed: C89.1, J1.5, R12.2, U7.52 (~RESET)
unnamed: C90.1, C91.1, U7.53 (VDDCORE)
unnamed: D1.2 (A), R25.1
unnamed: D2.2 (A), R26.1

Notes on the sheet:
Programming interface
SPI flash chip
Buzzer
Two indicator LEDs
Mechanical mounting holes

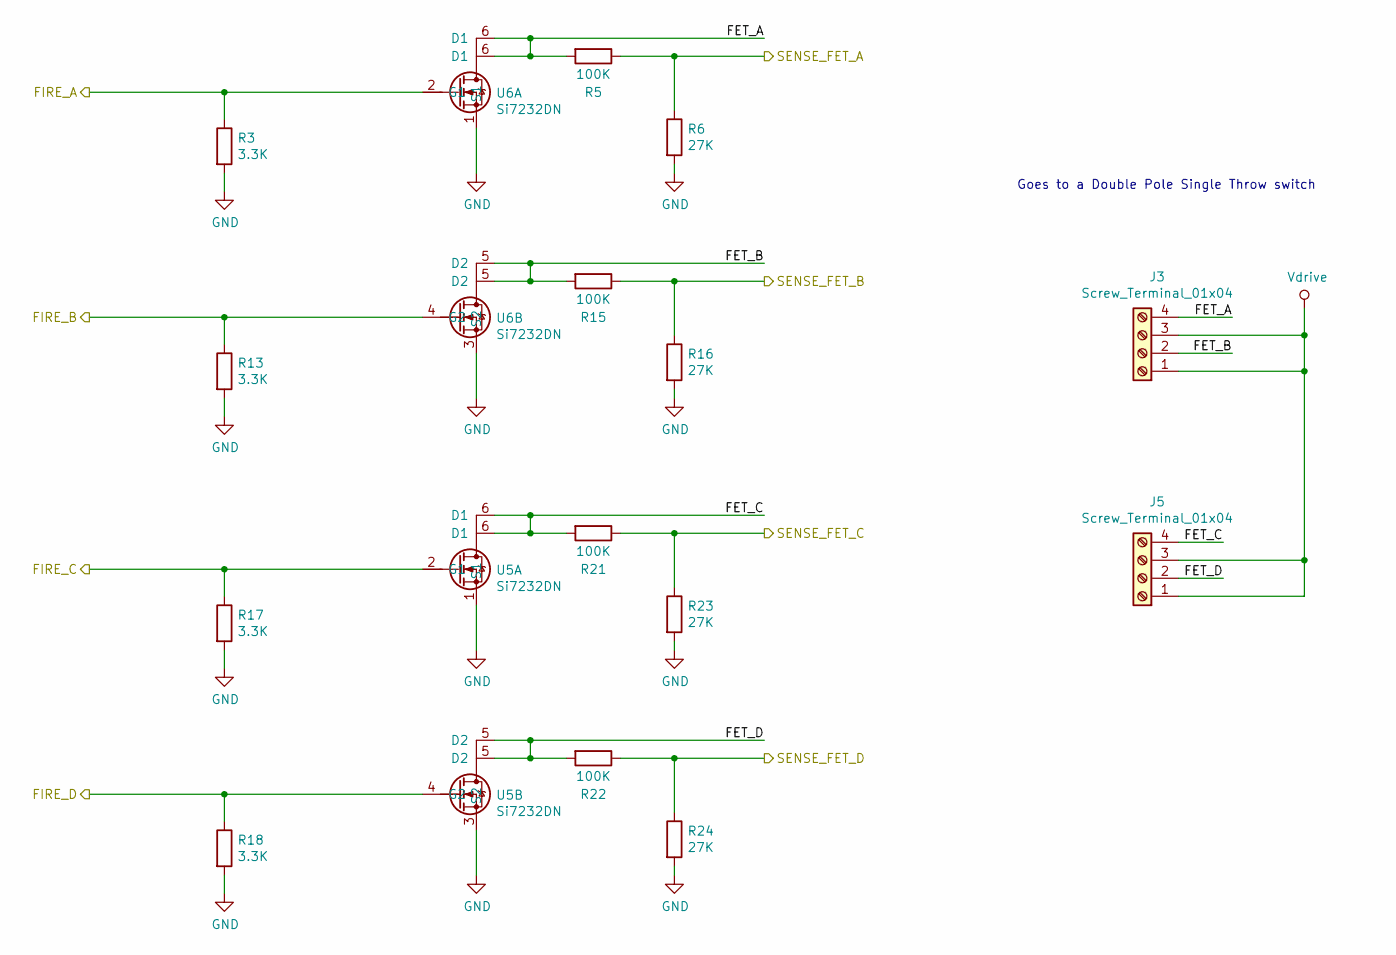
[picture p26: schematic pyro_driver.sch, Pyro drivers]

Parts:
J3, J5: Screw_Terminal_01x04; TerminalBlock_TE_282834-4_1x04_P2.54mm_Horizontal
R3, R13, R17, R18: 3.3K; R_0603_1608Metric
R5, R15, R21, R22: 100K; R_0603_1608Metric
R6, R16, R23, R24: 27K; R_0603_1608Metric
U5, U6: Si7232DN; Vishay_PowerPAK_1212-8_Dual

Connections:
/MCU/MCU_PA04: R5.1, R6.1; also elsewhere on the board
/MCU/MCU_PA05: R15.1, R16.1; also elsewhere on the board
/MCU/MCU_PA06: R21.1, R23.1; also elsewhere on the board
/MCU/MCU_PA07: R22.1, R24.1; also elsewhere on the board
/pyro_driver/FET_A: J3.4, R5.2, U6.6 (D1)
/pyro_driver/FET_B: J3.2, R15.2, U6.5 (D2)
/pyro_driver/FET_C: J5.4, R21.2, U5.6 (D1)
/pyro_driver/FET_D: J5.2, R22.2, U5.5 (D2)
/pyro_driver/FIRE_A: R3.1, U6.2 (G1); also elsewhere on the board
/pyro_driver/FIRE_B: R13.1, U6.4 (G2); also elsewhere on the board
/pyro_driver/FIRE_C: R17.1, U5.2 (G1); also elsewhere on the board
/pyro_driver/FIRE_D: R18.1, U5.4 (G2); also elsewhere on the board
GND: R3.2, R6.2, R13.2, R16.2, R17.2, R18.2, R23.2, R24.2, U5.1 (S1), U5.3 (S2), U6.1 (S1), U6.3 (S2); also elsewhere on the board
Vdrive: J3.1, J3.3, J5.1, J5.3; also elsewhere on the board

Notes on the sheet:
Goes to a Double Pole Single Throw switch

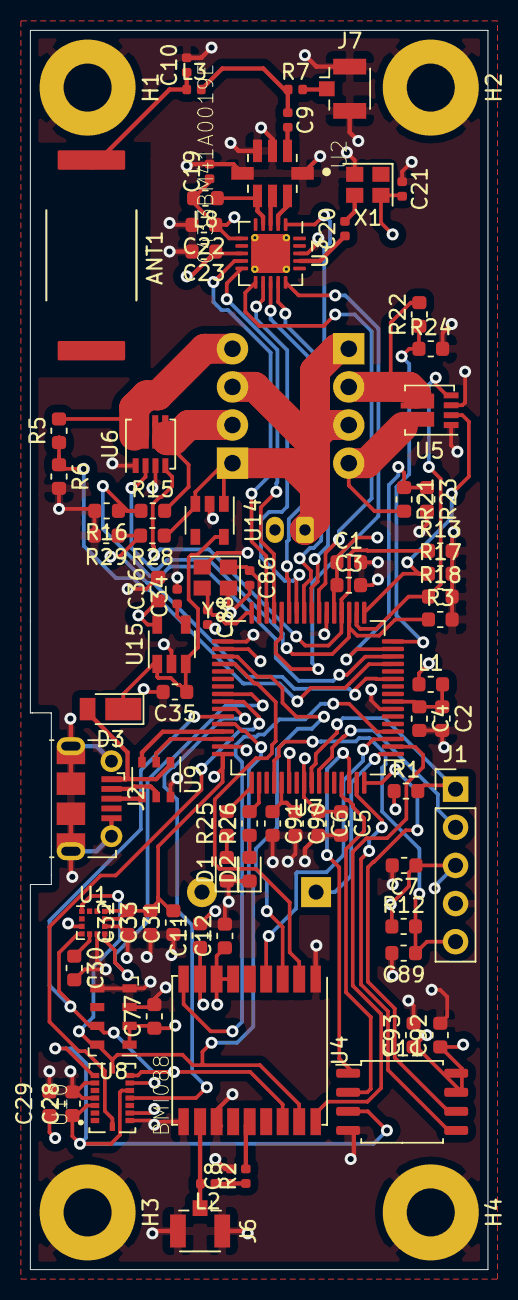
[picture p27: board circuit board design.kicad_pcb from above]

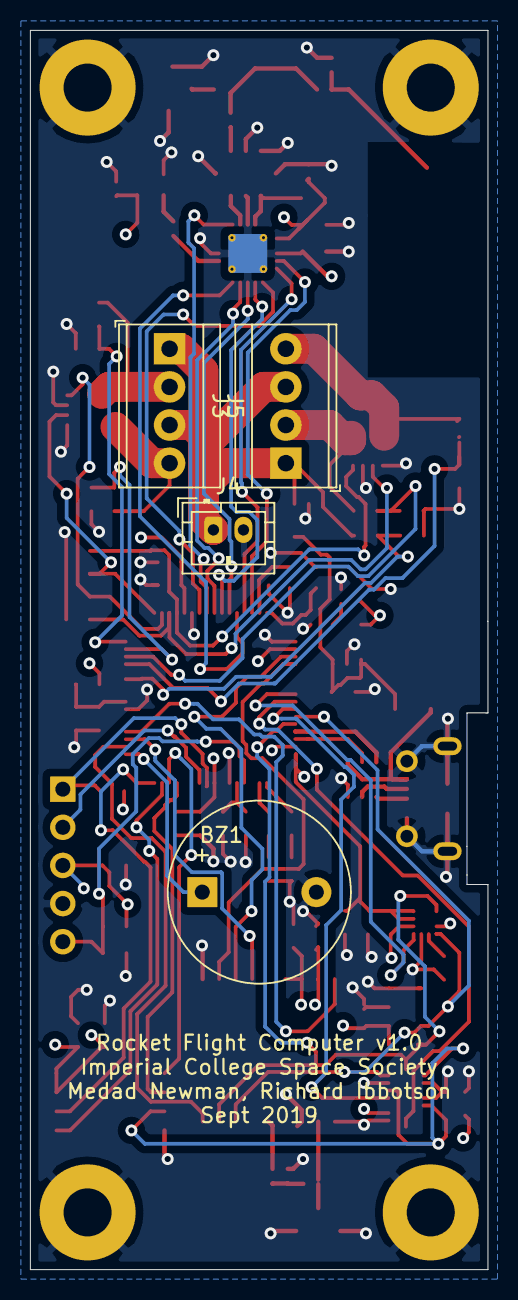
[picture p28: board circuit board design.kicad_pcb from below]

Board: 4 copper layers, 30.5 x 82.6 mm, 89 parts (4 on the bottom side), 70 nets.
