ImperialSpaceSociety/Project-Mach-1/Flight Computer V2.1/PCB/XBee PCB/Xbee extension.brd

## EAGLE design Flight Computer V2.1/PCB/XBee PCB/Xbee extension.brd (2022-06-04)

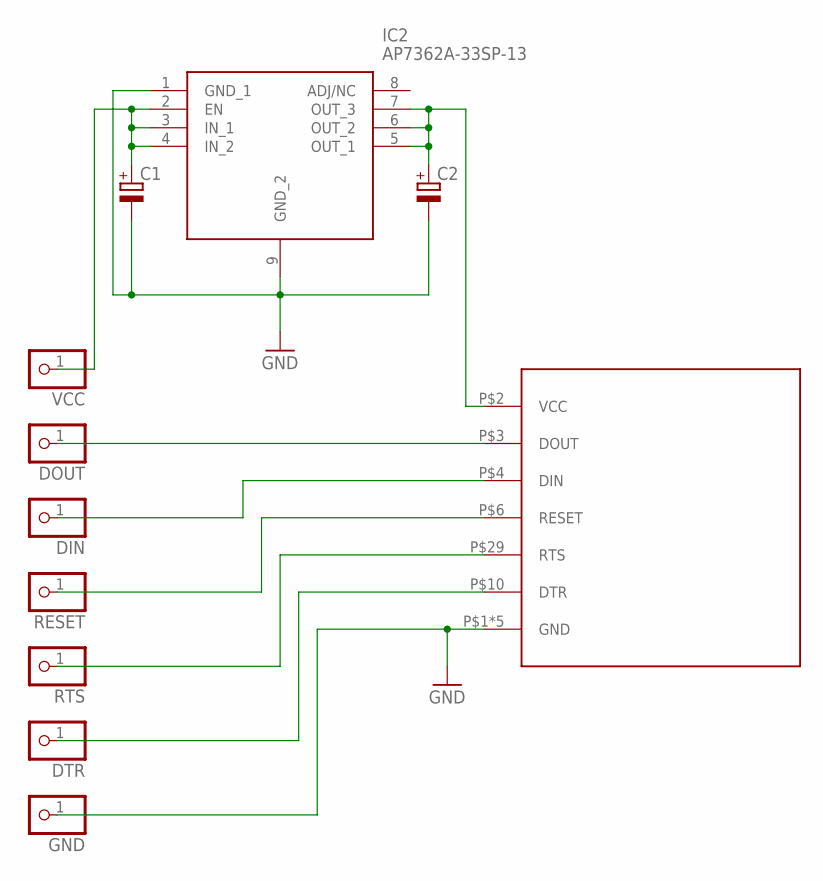
[picture p29: schematic Xbee extension.sch]

Parts:
C1, C2: CPOL-EU153CLV-0605; 153CLV-0605
DIN: PINHD-1X1; 1X01
DOUT: PINHD-1X1; 1X01
DTR: PINHD-1X1; 1X01
GND: PINHD-1X1; 1X01
IC2: AP7362A-33SP-13; SOIC127P600X150-9N
RESET: PINHD-1X1; 1X01
RTS: PINHD-1X1; 1X01
U$1: PRO_XTC
VCC: PINHD-1X1; 1X01

Connections:
GND: C1.-, C2.-, GND.1, IC2.1 (GND_1), IC2.9 (GND_2), U$1.P$1 (GND), U$1.P$11 (GND), U$1.P$13 (GND), U$1.P$22 (GND), U$1.P$35 (GND)
unnamed: C1.+, IC2.2 (EN), IC2.3 (IN_1), IC2.4 (IN_2), VCC.1
unnamed: DOUT.1, U$1.P$3 (DOUT)
unnamed: DIN.1, U$1.P$4 (DIN)
unnamed: RESET.1, U$1.P$6 (RESET)
unnamed: RTS.1, U$1.P$29 (RTS)
unnamed: DTR.1, U$1.P$10 (DTR)
unnamed: C2.+, IC2.5 (OUT_1), IC2.6 (OUT_2), IC2.7 (OUT_3), U$1.P$2 (VCC)

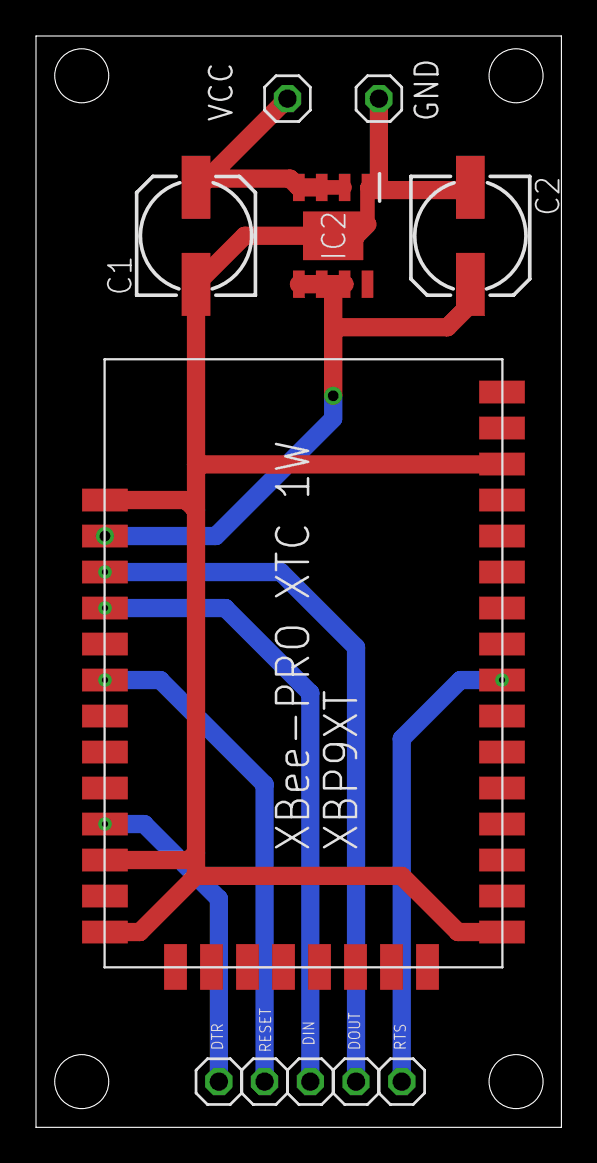
[picture p30: board Xbee extension.brd from above]

Board: 2 copper layers, 29.2 x 60.6 mm, 11 parts (0 on the bottom side), 8 nets.
