ImperialSpaceSociety/Project-Mach-1/Flight Computer V2.1/PCB/power_supply.brd

## EAGLE design Flight Computer V2.1/PCB/power_supply.brd (2021-12-06)

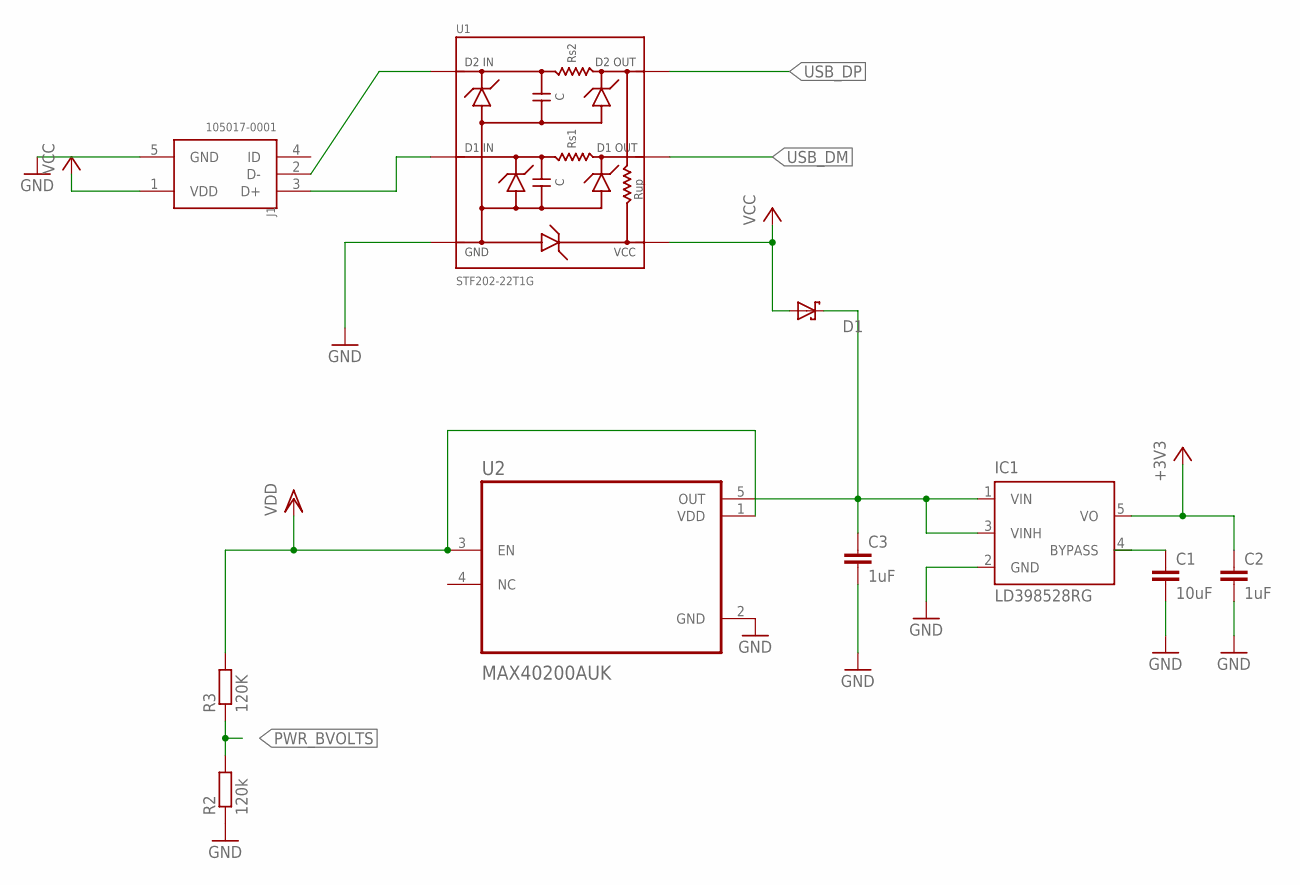
[picture p31: schematic power_supply.sch]

Parts:
C1: 10uF; C0603
C2, C3: 1uF; C0603
D1: SCHOTTKY-DIODEDFLS130L-7; POWERDI-123
IC1: LD398528RG; TSOT23-5L
J1: 105017-0001; MOLEX_105017-0001
R2: 120k; R0603
R3: 120K; R0603
U1: STF202-22T1G
U2: MAX40200AUK; 21-0057F

Connections:
+3V1: C3.1, D1.C, IC1.1 (VIN), IC1.3 (VINH), U2.5 (OUT)
+3V3: C2.1, IC1.5 (VO)
GND: C1.2, C2.2, C3.2, IC1.2 (GND), J1.5 (GND), R2.1, U1.6 (GND), U2.2 (GND)
unnamed: J1.2 (D-), U1.4 (D2-OUT)
unnamed: C1.1, IC1.4 (BYPASS)
PWR_BVOLTS: R2.2, R3.1
USB_DM: U1.2 (D1-IN)
USB_DP: J1.3 (D+), U1.3 (D2-IN), U1.5 (D1-OUT)
VCC: D1.A, J1.1 (VDD), U1.1 (VCC)
VDD: R3.2, U2.1 (VDD), U2.3 (EN)

Board: 2 copper layers, 10 parts (0 on the bottom side), 9 nets, no tracks yet.
