ImperialSpaceSociety/Project-Mach-1/Flight Computer V2.1/PCB/pyro_driver.brd

## EAGLE design Flight Computer V2.1/PCB/pyro_driver.brd (2021-11-27)

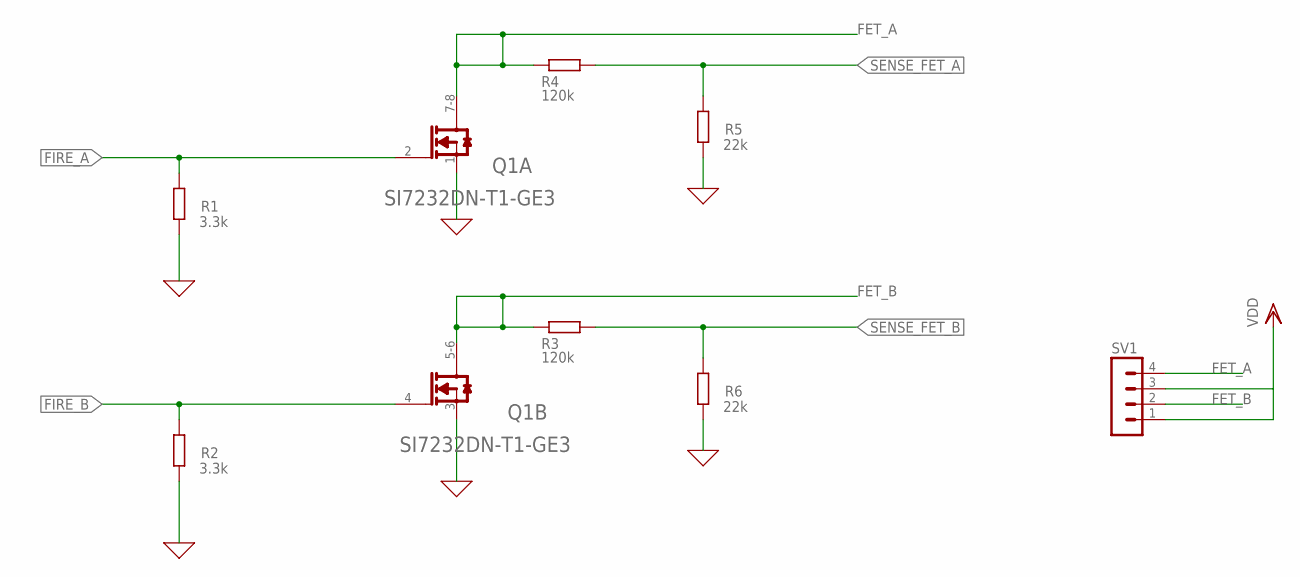
[picture p32: schematic pyro_driver.sch]

Parts:
Q1: VISHAY_SI7232DN-T1-GE3VISHAY_SI7232DN-T1-GE3_0_0; VISHAY_SI7232DN-T1-GE3_0
R1, R2: 3.3k; R0603
R3, R4: 120k; R0603
R5, R6: 22k; R0603
SV1: MA04-1

Connections:
0: Q1.1 (S1), Q1.3 (S2), R1.1, R2.1, R5.1, R6.1
FET_A: Q1.7-8 (D1), R4.1, SV1.4
FET_B: Q1.5-6 (D2), R3.1, SV1.2
FIRE_A: Q1.2 (G1), R1.2
FIRE_B: Q1.4 (G2), R2.2
SENSE_FET_A: R4.2, R5.2
SENSE_FET_B: R3.2, R6.2
VDD: SV1.1, SV1.3

Board: 2 copper layers, 8 parts (0 on the bottom side), 8 nets, no tracks yet.
