ImperialSpaceSociety/Project-Mach-1/Software/Atmel studio projects/SAMD flight computer code/SAMD flight computer code/atmel_start_pins.h

/*
 * Code generated from Atmel Start.
 *
 * This file will be overwritten when reconfiguring your Atmel Start project.
 * Please copy examples or other code you want to keep to a separate file
 * to avoid losing it when reconfiguring.
 */
#ifndef ATMEL_START_PINS_H_INCLUDED
#define ATMEL_START_PINS_H_INCLUDED

#include <hal_gpio.h>

// SAMD21 has 8 pin functions

#define GPIO_PIN_FUNCTION_A 0
#define GPIO_PIN_FUNCTION_B 1
#define GPIO_PIN_FUNCTION_C 2
#define GPIO_PIN_FUNCTION_D 3
#define GPIO_PIN_FUNCTION_E 4
#define GPIO_PIN_FUNCTION_F 5
#define GPIO_PIN_FUNCTION_G 6
#define GPIO_PIN_FUNCTION_H 7

#define PA08 GPIO(GPIO_PORTA, 8)
#define PA09 GPIO(GPIO_PORTA, 9)
#define PA16 GPIO(GPIO_PORTA, 16)
#define PA17 GPIO(GPIO_PORTA, 17)
#define PA22 GPIO(GPIO_PORTA, 22)
#define PA23 GPIO(GPIO_PORTA, 23)
#define PB00 GPIO(GPIO_PORTB, 0)
#define PB02 GPIO(GPIO_PORTB, 2)
#define PB03 GPIO(GPIO_PORTB, 3)
#define PB12 GPIO(GPIO_PORTB, 12)
#define PB13 GPIO(GPIO_PORTB, 13)
#define PB14 GPIO(GPIO_PORTB, 14)

#endif // ATMEL_START_PINS_H_INCLUDED
