ImperialSpaceSociety/Project-Mach-1/Software/Atmel studio projects/Flight computer code/Flight computer code/driver_init.c

/*
 * Code generated from Atmel Start.
 *
 * This file will be overwritten when reconfiguring your Atmel Start project.
 * Please copy examples or other code you want to keep to a separate file
 * to avoid losing it when reconfiguring.
 */

#include "driver_init.h"
#include <peripheral_clk_config.h>
#include <utils.h>
#include <hal_init.h>

struct spi_m_sync_descriptor SPI_RADIO;
struct spi_m_sync_descriptor SPI_FLASH_CHIP;

struct usart_sync_descriptor USART_0;

struct i2c_m_sync_desc I2C_0;

void SPI_RADIO_PORT_init(void)
{

	gpio_set_pin_level(PA04,
	                   // <y> Initial level
	                   // <id> pad_initial_level
	                   // <false"> Low
	                   // <true"> High
	                   false);

	// Set pin direction to output
	gpio_set_pin_direction(PA04, GPIO_DIRECTION_OUT);

	gpio_set_pin_function(PA04, PINMUX_PA04D_SERCOM0_PAD0);

	gpio_set_pin_level(PA05,
	                   // <y> Initial level
	                   // <id> pad_initial_level
	                   // <false"> Low
	                   // <true"> High
	                   false);

	// Set pin direction to output
	gpio_set_pin_direction(PA05, GPIO_DIRECTION_OUT);

	gpio_set_pin_function(PA05, PINMUX_PA05D_SERCOM0_PAD1);

	// Set pin direction to input
	gpio_set_pin_direction(PA06, GPIO_DIRECTION_IN);

	gpio_set_pin_pull_mode(PA06,
	                       // <y> Pull configuration
	                       // <id> pad_pull_config
	                       // <GPIO_PULL_OFF"> Off
	                       // <GPIO_PULL_UP"> Pull-up
	                       // <GPIO_PULL_DOWN"> Pull-down
	                       GPIO_PULL_OFF);

	gpio_set_pin_function(PA06, PINMUX_PA06D_SERCOM0_PAD2);
}

void SPI_RADIO_CLOCK_init(void)
{
	hri_gclk_write_PCHCTRL_reg(GCLK, SERCOM0_GCLK_ID_CORE, CONF_GCLK_SERCOM0_CORE_SRC | (1 << GCLK_PCHCTRL_CHEN_Pos));
	hri_gclk_write_PCHCTRL_reg(GCLK, SERCOM0_GCLK_ID_SLOW, CONF_GCLK_SERCOM0_SLOW_SRC | (1 << GCLK_PCHCTRL_CHEN_Pos));

	hri_mclk_set_APBCMASK_SERCOM0_bit(MCLK);
}

void SPI_RADIO_init(void)
{
	SPI_RADIO_CLOCK_init();
	spi_m_sync_init(&SPI_RADIO, SERCOM0);
	SPI_RADIO_PORT_init();
}

void USART_0_PORT_init(void)
{

	gpio_set_pin_function(PA16, PINMUX_PA16C_SERCOM1_PAD0);

	gpio_set_pin_function(PA17, PINMUX_PA17C_SERCOM1_PAD1);
}

void USART_0_CLOCK_init(void)
{
	hri_gclk_write_PCHCTRL_reg(GCLK, SERCOM1_GCLK_ID_CORE, CONF_GCLK_SERCOM1_CORE_SRC | (1 << GCLK_PCHCTRL_CHEN_Pos));
	hri_gclk_write_PCHCTRL_reg(GCLK, SERCOM1_GCLK_ID_SLOW, CONF_GCLK_SERCOM1_SLOW_SRC | (1 << GCLK_PCHCTRL_CHEN_Pos));

	hri_mclk_set_APBCMASK_SERCOM1_bit(MCLK);
}

void USART_0_init(void)
{
	USART_0_CLOCK_init();
	usart_sync_init(&USART_0, SERCOM1, (void *)NULL);
	USART_0_PORT_init();
}

void I2C_0_PORT_init(void)
{

	gpio_set_pin_pull_mode(PA22,
	                       // <y> Pull configuration
	                       // <id> pad_pull_config
	                       // <GPIO_PULL_OFF"> Off
	                       // <GPIO_PULL_UP"> Pull-up
	                       // <GPIO_PULL_DOWN"> Pull-down
	                       GPIO_PULL_OFF);

	gpio_set_pin_function(PA22, PINMUX_PA22C_SERCOM3_PAD0);

	gpio_set_pin_pull_mode(PA23,
	                       // <y> Pull configuration
	                       // <id> pad_pull_config
	                       // <GPIO_PULL_OFF"> Off
	                       // <GPIO_PULL_UP"> Pull-up
	                       // <GPIO_PULL_DOWN"> Pull-down
	                       GPIO_PULL_OFF);

	gpio_set_pin_function(PA23, PINMUX_PA23C_SERCOM3_PAD1);
}

void I2C_0_CLOCK_init(void)
{
	hri_gclk_write_PCHCTRL_reg(GCLK, SERCOM3_GCLK_ID_CORE, CONF_GCLK_SERCOM3_CORE_SRC | (1 << GCLK_PCHCTRL_CHEN_Pos));
	hri_gclk_write_PCHCTRL_reg(GCLK, SERCOM3_GCLK_ID_SLOW, CONF_GCLK_SERCOM3_SLOW_SRC | (1 << GCLK_PCHCTRL_CHEN_Pos));

	hri_mclk_set_APBCMASK_SERCOM3_bit(MCLK);
}

void I2C_0_init(void)
{
	I2C_0_CLOCK_init();
	i2c_m_sync_init(&I2C_0, SERCOM3);
	I2C_0_PORT_init();
}

void SPI_FLASH_CHIP_PORT_init(void)
{

	gpio_set_pin_level(PB12,
	                   // <y> Initial level
	                   // <id> pad_initial_level
	                   // <false"> Low
	                   // <true"> High
	                   false);

	// Set pin direction to output
	gpio_set_pin_direction(PB12, GPIO_DIRECTION_OUT);

	gpio_set_pin_function(PB12, PINMUX_PB12C_SERCOM4_PAD0);

	gpio_set_pin_level(PB13,
	                   // <y> Initial level
	                   // <id> pad_initial_level
	                   // <false"> Low
	                   // <true"> High
	                   false);

	// Set pin direction to output
	gpio_set_pin_direction(PB13, GPIO_DIRECTION_OUT);

	gpio_set_pin_function(PB13, PINMUX_PB13C_SERCOM4_PAD1);

	// Set pin direction to input
	gpio_set_pin_direction(PB14, GPIO_DIRECTION_IN);

	gpio_set_pin_pull_mode(PB14,
	                       // <y> Pull configuration
	                       // <id> pad_pull_config
	                       // <GPIO_PULL_OFF"> Off
	                       // <GPIO_PULL_UP"> Pull-up
	                       // <GPIO_PULL_DOWN"> Pull-down
	                       GPIO_PULL_OFF);

	gpio_set_pin_function(PB14, PINMUX_PB14C_SERCOM4_PAD2);
}

void SPI_FLASH_CHIP_CLOCK_init(void)
{
	hri_gclk_write_PCHCTRL_reg(GCLK, SERCOM4_GCLK_ID_CORE, CONF_GCLK_SERCOM4_CORE_SRC | (1 << GCLK_PCHCTRL_CHEN_Pos));
	hri_gclk_write_PCHCTRL_reg(GCLK, SERCOM4_GCLK_ID_SLOW, CONF_GCLK_SERCOM4_SLOW_SRC | (1 << GCLK_PCHCTRL_CHEN_Pos));

	hri_mclk_set_APBCMASK_SERCOM4_bit(MCLK);
}

void SPI_FLASH_CHIP_init(void)
{
	SPI_FLASH_CHIP_CLOCK_init();
	spi_m_sync_init(&SPI_FLASH_CHIP, SERCOM4);
	SPI_FLASH_CHIP_PORT_init();
}

void system_init(void)
{
	init_mcu();

	SPI_RADIO_init();

	USART_0_init();

	I2C_0_init();

	SPI_FLASH_CHIP_init();
}
