ImperialSpaceSociety/Project-Mach-1/Software/Arduino code/serial_gps_passthrough_one_way/serial_gps_passthrough_one_way.ino

// Test code forGPS Using Hardware Serial



// what's the name of the hardware serial port?
#define GPSSerial Serial1


void setup() {
  // wait for hardware serial to appear
  while (!Serial);

  // make this baud rate fast enough to we aren't waiting on it
  Serial.begin(115200);

  // 9600 baud is the default rate for the GPS
  GPSSerial.begin(9600);

}


void loop() {

  if (GPSSerial.available()) {
    char c = GPSSerial.read();
    Serial.write(c);
  }
  if (Serial.available()) {
    char c = Serial.read();
    GPSSerial.write(c);
  }
}
