ImperialSpaceSociety/Project-Mach-1/Software/Atmel studio projects/LED flasher/LED flasher/led_flasher_main.c

/**
 * \file
 *
 * \brief Application implement
 *
 * Copyright (c) 2015-2018 Microchip Technology Inc. and its subsidiaries.
 *
 * \asf_license_start
 *
 * \page License
 *
 * Subject to your compliance with these terms, you may use Microchip
 * software and any derivatives exclusively with Microchip products.
 * It is your responsibility to comply with third party license terms applicable
 * to your use of third party software (including open source software) that
 * may accompany Microchip software.
 *
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
 * \asf_license_stop
 *
 */
/*
 * Support and FAQ: visit <a href="https://www.microchip.com/support/">Microchip Support</a>
 */

#include "atmel_start.h"
#include <hal_gpio.h>
#include <hal_delay.h>

int main(void)
{
	atmel_start_init();

	while (true) {
		delay_ms(500);
		gpio_toggle_pin_level(LED0);
		//gpio_toggle_pin_level(LED1);

	}
}
