ImperialSpaceSociety/Project-Mach-1/Software/Custom board files for flight computer/1.5.9/cores/arduino/TinyUSB/Adafruit_TinyUSB_ArduinoCore/tinyusb/src/tusb_option.h

/*
 * The MIT License (MIT)
 *
 * Copyright (c) 2019 Ha Thach (tinyusb.org)
 *
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
 * This file is part of the TinyUSB stack.
 */

#ifndef _TUSB_OPTION_H_
#define _TUSB_OPTION_H_

#define TUSB_VERSION_MAJOR     0
#define TUSB_VERSION_MINOR     5
#define TUSB_VERSION_REVISION  0
#define TUSB_VERSION_STRING    TU_STRING(TUSB_VERSION_MAJOR) "." TU_STRING(TUSB_VERSION_MINOR) "." TU_STRING(TUSB_VERSION_REVISION)

/** \defgroup group_mcu Supported MCU
 * \ref CFG_TUSB_MCU must be defined to one of these
 *  @{ */

#define OPT_MCU_NONE                0

// LPC
#define OPT_MCU_LPC11UXX            1 ///< NXP LPC11Uxx
#define OPT_MCU_LPC13XX             2 ///< NXP LPC13xx
#define OPT_MCU_LPC15XX             3 ///< NXP LPC15xx
#define OPT_MCU_LPC175X_6X          4 ///< NXP LPC175x, LPC176x
#define OPT_MCU_LPC177X_8X          5 ///< NXP LPC177x, LPC178x
#define OPT_MCU_LPC18XX             6 ///< NXP LPC18xx
#define OPT_MCU_LPC40XX             7 ///< NXP LPC40xx
#define OPT_MCU_LPC43XX             8 ///< NXP LPC43xx
#define OPT_MCU_LPC51UXX            9 ///< NXP LPC51U6x
#define OPT_MCU_LPC54XXX           10 ///< NXP LPC54xxx
#define OPT_MCU_LPC55XX            11 ///< NXP LPC55xx

// NRF
#define OPT_MCU_NRF5X             100 ///< Nordic nRF5x series

// SAM
#define OPT_MCU_SAMD21            200 ///< MicroChip SAMD21
#define OPT_MCU_SAMD51            201 ///< MicroChip SAMD51
#define OPT_MCU_SAMG              202 ///< MicroChip SAMDG series

// STM32
#define OPT_MCU_STM32F0           300 ///< ST STM32F0
#define OPT_MCU_STM32F1           301 ///< ST STM32F1
#define OPT_MCU_STM32F2           302 ///< ST STM32F2
#define OPT_MCU_STM32F3           303 ///< ST STM32F3
#define OPT_MCU_STM32F4           304 ///< ST STM32F4
#define OPT_MCU_STM32F7           305 ///< ST STM32F7
#define OPT_MCU_STM32H7           306 ///< ST STM32H7
#define OPT_MCU_STM32L0           307 ///< ST STM32L0
#define OPT_MCU_STM32L1           308 ///< ST STM32L1
#define OPT_MCU_STM32L4           309 ///< ST STM32L4

#define OPT_MCU_CXD56             400 ///< SONY CXD56

#define OPT_MCU_VALENTYUSB_EPTRI  600 ///< Fomu eptri config

#define OPT_MCU_MIMXRT10XX        700 ///< NXP iMX RT10xx

/** @} */

/** \defgroup group_supported_os Supported RTOS
 *  \ref CFG_TUSB_OS must be defined to one of these
 *  @{ */
#define OPT_OS_NONE       1 ///< No RTOS
#define OPT_OS_FREERTOS   2 ///< FreeRTOS
#define OPT_OS_MYNEWT     3 ///< Mynewt OS
/** @} */


// Allow to use command line to change the config name/location
#ifndef CFG_TUSB_CONFIG_FILE
  #define CFG_TUSB_CONFIG_FILE "tusb_config.h"
#endif

#include CFG_TUSB_CONFIG_FILE

/** \addtogroup group_configuration
 *  @{ */

//--------------------------------------------------------------------
// CONTROLLER
// Only 1 roothub port can be configured to be device and/or host.
// tinyusb does not support dual devices or dual host configuration
//--------------------------------------------------------------------
/** \defgroup group_mode Controller Mode Selection
 * \brief CFG_TUSB_CONTROLLER_N_MODE must be defined with these
 *  @{ */
#define OPT_MODE_NONE         0x00 ///< Disabled
#define OPT_MODE_DEVICE       0x01 ///< Device Mode
#define OPT_MODE_HOST         0x02 ///< Host Mode
#define OPT_MODE_HIGH_SPEED   0x10 ///< High speed
/** @} */

#ifndef CFG_TUSB_RHPORT0_MODE
  #define CFG_TUSB_RHPORT0_MODE OPT_MODE_NONE
#endif

#ifndef CFG_TUSB_RHPORT1_MODE
  #define CFG_TUSB_RHPORT1_MODE OPT_MODE_NONE
#endif

#if ((CFG_TUSB_RHPORT0_MODE & OPT_MODE_HOST) && (CFG_TUSB_RHPORT1_MODE & OPT_MODE_HOST)) || \
    ((CFG_TUSB_RHPORT0_MODE & OPT_MODE_DEVICE) && (CFG_TUSB_RHPORT1_MODE & OPT_MODE_DEVICE))
  #error "tinyusb does not support same modes on more than 1 roothub port"
#endif

// Which roothub port is configured as host
#define TUH_OPT_RHPORT          ( (CFG_TUSB_RHPORT0_MODE & OPT_MODE_HOST) ? 0 : ((CFG_TUSB_RHPORT1_MODE & OPT_MODE_HOST) ? 1 : -1) )
#define TUSB_OPT_HOST_ENABLED   ( TUH_OPT_RHPORT >= 0 )

// Which roothub port is configured as device
#define TUD_OPT_RHPORT          ( (CFG_TUSB_RHPORT0_MODE & OPT_MODE_DEVICE) ? 0 : ((CFG_TUSB_RHPORT1_MODE & OPT_MODE_DEVICE) ? 1 : -1) )

#if TUD_OPT_RHPORT == 0
#define TUD_OPT_HIGH_SPEED      ( CFG_TUSB_RHPORT0_MODE & OPT_MODE_HIGH_SPEED )
#else
#define TUD_OPT_HIGH_SPEED      ( CFG_TUSB_RHPORT1_MODE & OPT_MODE_HIGH_SPEED )
#endif

#define TUSB_OPT_DEVICE_ENABLED ( TUD_OPT_RHPORT >= 0 )


//--------------------------------------------------------------------+
// COMMON OPTIONS
//--------------------------------------------------------------------+

// Debug enable to print out error message
#ifndef CFG_TUSB_DEBUG
  #define CFG_TUSB_DEBUG 0
#endif

// place data in accessible RAM for usb controller
#ifndef CFG_TUSB_MEM_SECTION
#define CFG_TUSB_MEM_SECTION
#endif

#ifndef CFG_TUSB_MEM_ALIGN
#define CFG_TUSB_MEM_ALIGN        TU_ATTR_ALIGNED(4)
#endif

#ifndef CFG_TUSB_OS
#define CFG_TUSB_OS               OPT_OS_NONE
#endif

//--------------------------------------------------------------------
// DEVICE OPTIONS
//--------------------------------------------------------------------

#ifndef CFG_TUD_ENDPOINT0_SIZE
  #define CFG_TUD_ENDPOINT0_SIZE   64
#endif

#ifndef CFG_TUD_CDC
  #define CFG_TUD_CDC             0
#endif

#ifndef CFG_TUD_MSC
  #define CFG_TUD_MSC             0
#endif

#ifndef CFG_TUD_HID
  #define CFG_TUD_HID             0
#endif

#ifndef CFG_TUD_MIDI
  #define CFG_TUD_MIDI            0
#endif

#ifndef CFG_TUD_VENDOR
  #define CFG_TUD_VENDOR          0
#endif

#ifndef CFG_TUD_USBTMC
  #define CFG_TUD_USBTMC          0
#endif

#ifndef CFG_TUD_DFU_RT
  #define CFG_TUD_DFU_RT          0
#endif


//--------------------------------------------------------------------
// HOST OPTIONS
//--------------------------------------------------------------------
#if TUSB_OPT_HOST_ENABLED
  #ifndef CFG_TUSB_HOST_DEVICE_MAX
    #define CFG_TUSB_HOST_DEVICE_MAX 1
    #warning CFG_TUSB_HOST_DEVICE_MAX is not defined, default value is 1
  #endif

  //------------- HUB CLASS -------------//
  #if CFG_TUH_HUB && (CFG_TUSB_HOST_DEVICE_MAX == 1)
    #error there is no benefit enable hub with max device is 1. Please disable hub or increase CFG_TUSB_HOST_DEVICE_MAX
  #endif

  //------------- HID CLASS -------------//
  #define HOST_CLASS_HID   ( CFG_TUH_HID_KEYBOARD + CFG_TUH_HID_MOUSE + CFG_TUSB_HOST_HID_GENERIC )

  #ifndef CFG_TUSB_HOST_ENUM_BUFFER_SIZE
    #define CFG_TUSB_HOST_ENUM_BUFFER_SIZE 256
  #endif

  //------------- CLASS -------------//
#endif // TUSB_OPT_HOST_ENABLED


//------------------------------------------------------------------
// Configuration Validation
//------------------------------------------------------------------
#if CFG_TUD_ENDPOINT0_SIZE > 64
  #error Control Endpoint Max Packet Size cannot be larger than 64
#endif

#endif /* _TUSB_OPTION_H_ */

/** @} */
