ImperialSpaceSociety/Project-Mach-1/Software/Arduino code/flash_tests/SdFat_ReadWrite/SdFat_ReadWrite.ino

/*
  SD card read/write

 This example shows how to read and write data to and from an SD card file
 The circuit:
 * SD card attached to SPI bus as follows:
 ** MOSI - pin 11
 ** MISO - pin 12
 ** CLK - pin 13

 created   Nov 2010
 by David A. Mellis
 modified 9 Apr 2012
 by Tom Igoe

 This example code is in the public domain.

 */

#include <SPI.h>
#include "SdFat.h"
#include "Adafruit_SPIFlash.h"


// Uncomment to run example with custom SPI and SS e.g with FRAM breakout
 #define CUSTOM_CS   SS1
 #define CUSTOM_SPI  SPI1

#if defined(CUSTOM_CS) && defined(CUSTOM_SPI)
  Adafruit_FlashTransport_SPI flashTransport(CUSTOM_CS, CUSTOM_SPI);

#elif CONFIG_IDF_TARGET_ESP32S2
  // ESP32-S2 use same flash device that store code.
  // Therefore there is no need to specify the SPI and SS
  Adafruit_FlashTransport_ESP32 flashTransport;

#else
  // On-board external flash (QSPI or SPI) macros should already
  // defined in your board variant if supported
  // - EXTERNAL_FLASH_USE_QSPI
  // - EXTERNAL_FLASH_USE_CS/EXTERNAL_FLASH_USE_SPI
  #if defined(EXTERNAL_FLASH_USE_QSPI)
    Adafruit_FlashTransport_QSPI flashTransport;

  #elif defined(EXTERNAL_FLASH_USE_SPI)
    Adafruit_FlashTransport_SPI flashTransport(EXTERNAL_FLASH_USE_CS, EXTERNAL_FLASH_USE_SPI);

  #else
    #error No QSPI/SPI flash are defined on your board variant.h !
  #endif
#endif

Adafruit_SPIFlash flash(&flashTransport);

static const SPIFlash_Device_t my_flash_devices[] = {
    W25Q64JV_IM,
};
/*
 * Specify the number of different devices that are listed in the array we just created. If you add more devices to the array, update this value to match.
 */
const int flashDevices = 1;


// file system object from SdFat
FatFileSystem fatfs;

File myFile;

void setup() {
  // Open serial communications and wait for port to open:
  Serial.begin(115200);
  while (!Serial) {
    delay(1); // wait for serial port to connect. Needed for native USB port only
  }

  Serial.print("Initializing Filesystem on external flash...");
  
  // Init external flash
  flash.begin(my_flash_devices, flashDevices);

  // Open file system on the flash
  if ( !fatfs.begin(&flash) ) {
    Serial.println("Error: filesystem is not existed. Please try SdFat_format example to make one.");
    while(1) yield();
  }

  Serial.println("initialization done.");

  // open the file. note that only one file can be open at a time,
  // so you have to close this one before opening another.
  myFile = fatfs.open("test.txt", FILE_WRITE);

  // if the file opened okay, write to it:
  if (myFile) {
    Serial.print("Writing to test.txt...");
    myFile.println("testing 1, 2, 3.");
    // close the file:
    myFile.close();
    Serial.println("done.");
  } else {
    // if the file didn't open, print an error:
    Serial.println("error opening test.txt");
  }

  // re-open the file for reading:
  myFile = fatfs.open("test.txt");
  if (myFile) {
    Serial.println("test.txt:");

    // read from the file until there's nothing else in it:
    while (myFile.available()) {
      Serial.write(myFile.read());
    }
    // close the file:
    myFile.close();
  } else {
    // if the file didn't open, print an error:
    Serial.println("error opening test.txt");
  }
}

void loop() {
  // nothing happens after setup
}
