ImperialSpaceSociety/Project-Mach-1/Software/Atmel studio projects/Ricky_Tests/I2C_Scanner/GPS_Passthrough/driver_init.c

/*
 * Code generated from Atmel Start.
 *
 * This file will be overwritten when reconfiguring your Atmel Start project.
 * Please copy examples or other code you want to keep to a separate file
 * to avoid losing it when reconfiguring.
 */

#include "driver_init.h"
#include <peripheral_clk_config.h>
#include <utils.h>
#include <hal_init.h>
#include <hpl_gclk_base.h>
#include <hpl_pm_base.h>

#include <hpl_adc_base.h>

/*! The buffer size for USART */
#define USART_0_BUFFER_SIZE 16

struct usart_async_descriptor USART_0;
struct spi_m_sync_descriptor  SPI_1;
struct spi_m_sync_descriptor  SPI_0;

static uint8_t USART_0_buffer[USART_0_BUFFER_SIZE];

struct adc_sync_descriptor ADC_0;

struct i2c_m_sync_desc I2C_1;

struct i2c_m_sync_desc I2C_0;

void ADC_0_PORT_init(void)
{

	// Disable digital pin circuitry
	gpio_set_pin_direction(PWR_BVOLTS, GPIO_DIRECTION_OFF);

	gpio_set_pin_function(PWR_BVOLTS, PINMUX_PB08B_ADC_AIN2);

	// Disable digital pin circuitry
	gpio_set_pin_direction(SENSE_A, GPIO_DIRECTION_OFF);

	gpio_set_pin_function(SENSE_A, PINMUX_PA04B_ADC_AIN4);

	// Disable digital pin circuitry
	gpio_set_pin_direction(PA05, GPIO_DIRECTION_OFF);

	gpio_set_pin_function(PA05, PINMUX_PA05B_ADC_AIN5);
}

void ADC_0_CLOCK_init(void)
{
	_pm_enable_bus_clock(PM_BUS_APBC, ADC);
	_gclk_enable_channel(ADC_GCLK_ID, CONF_GCLK_ADC_SRC);
}

void ADC_0_init(void)
{
	ADC_0_CLOCK_init();
	ADC_0_PORT_init();
	adc_sync_init(&ADC_0, ADC, (void *)NULL);
}

void I2C_1_PORT_init(void)
{

	gpio_set_pin_pull_mode(PA08,
	                       // <y> Pull configuration
	                       // <id> pad_pull_config
	                       // <GPIO_PULL_OFF"> Off
	                       // <GPIO_PULL_UP"> Pull-up
	                       // <GPIO_PULL_DOWN"> Pull-down
	                       GPIO_PULL_OFF);

	gpio_set_pin_function(PA08, PINMUX_PA08C_SERCOM0_PAD0);

	gpio_set_pin_pull_mode(PA09,
	                       // <y> Pull configuration
	                       // <id> pad_pull_config
	                       // <GPIO_PULL_OFF"> Off
	                       // <GPIO_PULL_UP"> Pull-up
	                       // <GPIO_PULL_DOWN"> Pull-down
	                       GPIO_PULL_OFF);

	gpio_set_pin_function(PA09, PINMUX_PA09C_SERCOM0_PAD1);
}

void I2C_1_CLOCK_init(void)
{
	_pm_enable_bus_clock(PM_BUS_APBC, SERCOM0);
	_gclk_enable_channel(SERCOM0_GCLK_ID_CORE, CONF_GCLK_SERCOM0_CORE_SRC);
	_gclk_enable_channel(SERCOM0_GCLK_ID_SLOW, CONF_GCLK_SERCOM0_SLOW_SRC);
}

void I2C_1_init(void)
{
	I2C_1_CLOCK_init();
	i2c_m_sync_init(&I2C_1, SERCOM0);
	I2C_1_PORT_init();
}

/**
 * \brief USART Clock initialization function
 *
 * Enables register interface and peripheral clock
 */
void USART_0_CLOCK_init()
{

	_pm_enable_bus_clock(PM_BUS_APBC, SERCOM1);
	_gclk_enable_channel(SERCOM1_GCLK_ID_CORE, CONF_GCLK_SERCOM1_CORE_SRC);
}

/**
 * \brief USART pinmux initialization function
 *
 * Set each required pin to USART functionality
 */
void USART_0_PORT_init()
{

	gpio_set_pin_function(PA16, PINMUX_PA16C_SERCOM1_PAD0);

	gpio_set_pin_function(PA17, PINMUX_PA17C_SERCOM1_PAD1);
}

/**
 * \brief USART initialization function
 *
 * Enables USART peripheral, clocks and initializes USART driver
 */
void USART_0_init(void)
{
	USART_0_CLOCK_init();
	usart_async_init(&USART_0, SERCOM1, USART_0_buffer, USART_0_BUFFER_SIZE, (void *)NULL);
	USART_0_PORT_init();
}

void I2C_0_PORT_init(void)
{

	gpio_set_pin_pull_mode(PA22,
	                       // <y> Pull configuration
	                       // <id> pad_pull_config
	                       // <GPIO_PULL_OFF"> Off
	                       // <GPIO_PULL_UP"> Pull-up
	                       // <GPIO_PULL_DOWN"> Pull-down
	                       GPIO_PULL_OFF);

	gpio_set_pin_function(PA22, PINMUX_PA22C_SERCOM3_PAD0);

	gpio_set_pin_pull_mode(PA23,
	                       // <y> Pull configuration
	                       // <id> pad_pull_config
	                       // <GPIO_PULL_OFF"> Off
	                       // <GPIO_PULL_UP"> Pull-up
	                       // <GPIO_PULL_DOWN"> Pull-down
	                       GPIO_PULL_OFF);

	gpio_set_pin_function(PA23, PINMUX_PA23C_SERCOM3_PAD1);
}

void I2C_0_CLOCK_init(void)
{
	_pm_enable_bus_clock(PM_BUS_APBC, SERCOM3);
	_gclk_enable_channel(SERCOM3_GCLK_ID_CORE, CONF_GCLK_SERCOM3_CORE_SRC);
	_gclk_enable_channel(SERCOM3_GCLK_ID_SLOW, CONF_GCLK_SERCOM3_SLOW_SRC);
}

void I2C_0_init(void)
{
	I2C_0_CLOCK_init();
	i2c_m_sync_init(&I2C_0, SERCOM3);
	I2C_0_PORT_init();
}

void SPI_1_PORT_init(void)
{

	gpio_set_pin_level(PB12,
	                   // <y> Initial level
	                   // <id> pad_initial_level
	                   // <false"> Low
	                   // <true"> High
	                   false);

	// Set pin direction to output
	gpio_set_pin_direction(PB12, GPIO_DIRECTION_OUT);

	gpio_set_pin_function(PB12, PINMUX_PB12C_SERCOM4_PAD0);

	gpio_set_pin_level(PB13,
	                   // <y> Initial level
	                   // <id> pad_initial_level
	                   // <false"> Low
	                   // <true"> High
	                   false);

	// Set pin direction to output
	gpio_set_pin_direction(PB13, GPIO_DIRECTION_OUT);

	gpio_set_pin_function(PB13, PINMUX_PB13C_SERCOM4_PAD1);

	// Set pin direction to input
	gpio_set_pin_direction(PB14, GPIO_DIRECTION_IN);

	gpio_set_pin_pull_mode(PB14,
	                       // <y> Pull configuration
	                       // <id> pad_pull_config
	                       // <GPIO_PULL_OFF"> Off
	                       // <GPIO_PULL_UP"> Pull-up
	                       // <GPIO_PULL_DOWN"> Pull-down
	                       GPIO_PULL_OFF);

	gpio_set_pin_function(PB14, PINMUX_PB14C_SERCOM4_PAD2);
}

void SPI_1_CLOCK_init(void)
{
	_pm_enable_bus_clock(PM_BUS_APBC, SERCOM4);
	_gclk_enable_channel(SERCOM4_GCLK_ID_CORE, CONF_GCLK_SERCOM4_CORE_SRC);
}

void SPI_1_init(void)
{
	SPI_1_CLOCK_init();
	spi_m_sync_init(&SPI_1, SERCOM4);
	SPI_1_PORT_init();
}

void SPI_0_PORT_init(void)
{

	gpio_set_pin_level(PB02,
	                   // <y> Initial level
	                   // <id> pad_initial_level
	                   // <false"> Low
	                   // <true"> High
	                   false);

	// Set pin direction to output
	gpio_set_pin_direction(PB02, GPIO_DIRECTION_OUT);

	gpio_set_pin_function(PB02, PINMUX_PB02D_SERCOM5_PAD0);

	gpio_set_pin_level(PB03,
	                   // <y> Initial level
	                   // <id> pad_initial_level
	                   // <false"> Low
	                   // <true"> High
	                   false);

	// Set pin direction to output
	gpio_set_pin_direction(PB03, GPIO_DIRECTION_OUT);

	gpio_set_pin_function(PB03, PINMUX_PB03D_SERCOM5_PAD1);

	// Set pin direction to input
	gpio_set_pin_direction(PB00, GPIO_DIRECTION_IN);

	gpio_set_pin_pull_mode(PB00,
	                       // <y> Pull configuration
	                       // <id> pad_pull_config
	                       // <GPIO_PULL_OFF"> Off
	                       // <GPIO_PULL_UP"> Pull-up
	                       // <GPIO_PULL_DOWN"> Pull-down
	                       GPIO_PULL_OFF);

	gpio_set_pin_function(PB00, PINMUX_PB00D_SERCOM5_PAD2);
}

void SPI_0_CLOCK_init(void)
{
	_pm_enable_bus_clock(PM_BUS_APBC, SERCOM5);
	_gclk_enable_channel(SERCOM5_GCLK_ID_CORE, CONF_GCLK_SERCOM5_CORE_SRC);
}

void SPI_0_init(void)
{
	SPI_0_CLOCK_init();
	spi_m_sync_init(&SPI_0, SERCOM5);
	SPI_0_PORT_init();
}

void TARGET_USB_PORT_init(void)
{

	gpio_set_pin_direction(USB_DM,
	                       // <y> Pin direction
	                       // <id> pad_direction
	                       // <GPIO_DIRECTION_OFF"> Off
	                       // <GPIO_DIRECTION_IN"> In
	                       // <GPIO_DIRECTION_OUT"> Out
	                       GPIO_DIRECTION_OUT);

	gpio_set_pin_level(USB_DM,
	                   // <y> Initial level
	                   // <id> pad_initial_level
	                   // <false"> Low
	                   // <true"> High
	                   false);

	gpio_set_pin_pull_mode(USB_DM,
	                       // <y> Pull configuration
	                       // <id> pad_pull_config
	                       // <GPIO_PULL_OFF"> Off
	                       // <GPIO_PULL_UP"> Pull-up
	                       // <GPIO_PULL_DOWN"> Pull-down
	                       GPIO_PULL_OFF);

	gpio_set_pin_function(USB_DM,
	                      // <y> Pin function
	                      // <id> pad_function
	                      // <i> Auto : use driver pinmux if signal is imported by driver, else turn off function
	                      // <PINMUX_PA24G_USB_DM"> Auto
	                      // <GPIO_PIN_FUNCTION_OFF"> Off
	                      // <GPIO_PIN_FUNCTION_A"> A
	                      // <GPIO_PIN_FUNCTION_B"> B
	                      // <GPIO_PIN_FUNCTION_C"> C
	                      // <GPIO_PIN_FUNCTION_D"> D
	                      // <GPIO_PIN_FUNCTION_E"> E
	                      // <GPIO_PIN_FUNCTION_F"> F
	                      // <GPIO_PIN_FUNCTION_G"> G
	                      // <GPIO_PIN_FUNCTION_H"> H
	                      PINMUX_PA24G_USB_DM);

	gpio_set_pin_direction(USB_DP,
	                       // <y> Pin direction
	                       // <id> pad_direction
	                       // <GPIO_DIRECTION_OFF"> Off
	                       // <GPIO_DIRECTION_IN"> In
	                       // <GPIO_DIRECTION_OUT"> Out
	                       GPIO_DIRECTION_OUT);

	gpio_set_pin_level(USB_DP,
	                   // <y> Initial level
	                   // <id> pad_initial_level
	                   // <false"> Low
	                   // <true"> High
	                   false);

	gpio_set_pin_pull_mode(USB_DP,
	                       // <y> Pull configuration
	                       // <id> pad_pull_config
	                       // <GPIO_PULL_OFF"> Off
	                       // <GPIO_PULL_UP"> Pull-up
	                       // <GPIO_PULL_DOWN"> Pull-down
	                       GPIO_PULL_OFF);

	gpio_set_pin_function(USB_DP,
	                      // <y> Pin function
	                      // <id> pad_function
	                      // <i> Auto : use driver pinmux if signal is imported by driver, else turn off function
	                      // <PINMUX_PA25G_USB_DP"> Auto
	                      // <GPIO_PIN_FUNCTION_OFF"> Off
	                      // <GPIO_PIN_FUNCTION_A"> A
	                      // <GPIO_PIN_FUNCTION_B"> B
	                      // <GPIO_PIN_FUNCTION_C"> C
	                      // <GPIO_PIN_FUNCTION_D"> D
	                      // <GPIO_PIN_FUNCTION_E"> E
	                      // <GPIO_PIN_FUNCTION_F"> F
	                      // <GPIO_PIN_FUNCTION_G"> G
	                      // <GPIO_PIN_FUNCTION_H"> H
	                      PINMUX_PA25G_USB_DP);
}

/* The USB module requires a GCLK_USB of 48 MHz ~ 0.25% clock
 * for low speed and full speed operation. */
#if (CONF_GCLK_USB_FREQUENCY > (48000000 + 48000000 / 400)) || (CONF_GCLK_USB_FREQUENCY < (48000000 - 48000000 / 400))
#warning USB clock should be 48MHz ~ 0.25% clock, check your configuration!
#endif

void TARGET_USB_CLOCK_init(void)
{

	_pm_enable_bus_clock(PM_BUS_APBB, USB);
	_pm_enable_bus_clock(PM_BUS_AHB, USB);
	_gclk_enable_channel(USB_GCLK_ID, CONF_GCLK_USB_SRC);
}

void TARGET_USB_init(void)
{
	TARGET_USB_CLOCK_init();
	usb_d_init();
	TARGET_USB_PORT_init();
}

void system_init(void)
{
	init_mcu();

	// GPIO on PA00

	gpio_set_pin_level(BUZZER,
	                   // <y> Initial level
	                   // <id> pad_initial_level
	                   // <false"> Low
	                   // <true"> High
	                   false);

	// Set pin direction to output
	gpio_set_pin_direction(BUZZER, GPIO_DIRECTION_OUT);

	gpio_set_pin_function(BUZZER, GPIO_PIN_FUNCTION_OFF);

	// GPIO on PA01

	gpio_set_pin_level(GPS_SAFEBOOT,
	                   // <y> Initial level
	                   // <id> pad_initial_level
	                   // <false"> Low
	                   // <true"> High
	                   false);

	// Set pin direction to output
	gpio_set_pin_direction(GPS_SAFEBOOT, GPIO_DIRECTION_OUT);

	gpio_set_pin_function(GPS_SAFEBOOT, GPIO_PIN_FUNCTION_OFF);

	// GPIO on PA02

	// Set pin direction to input
	gpio_set_pin_direction(GPS_PPS, GPIO_DIRECTION_IN);

	gpio_set_pin_pull_mode(GPS_PPS,
	                       // <y> Pull configuration
	                       // <id> pad_pull_config
	                       // <GPIO_PULL_OFF"> Off
	                       // <GPIO_PULL_UP"> Pull-up
	                       // <GPIO_PULL_DOWN"> Pull-down
	                       GPIO_PULL_OFF);

	gpio_set_pin_function(GPS_PPS, GPIO_PIN_FUNCTION_OFF);

	// GPIO on PA03

	gpio_set_pin_level(GPS_RES,
	                   // <y> Initial level
	                   // <id> pad_initial_level
	                   // <false"> Low
	                   // <true"> High
	                   false);

	// Set pin direction to output
	gpio_set_pin_direction(GPS_RES, GPIO_DIRECTION_OUT);

	gpio_set_pin_function(GPS_RES, GPIO_PIN_FUNCTION_OFF);

	// GPIO on PA10

	gpio_set_pin_level(FIRE_A,
	                   // <y> Initial level
	                   // <id> pad_initial_level
	                   // <false"> Low
	                   // <true"> High
	                   false);

	// Set pin direction to output
	gpio_set_pin_direction(FIRE_A, GPIO_DIRECTION_OUT);

	gpio_set_pin_function(FIRE_A, GPIO_PIN_FUNCTION_OFF);

	// GPIO on PA11

	gpio_set_pin_level(FIRE_B,
	                   // <y> Initial level
	                   // <id> pad_initial_level
	                   // <false"> Low
	                   // <true"> High
	                   false);

	// Set pin direction to output
	gpio_set_pin_direction(FIRE_B, GPIO_DIRECTION_OUT);

	gpio_set_pin_function(FIRE_B, GPIO_PIN_FUNCTION_OFF);

	// GPIO on PA12

	// Set pin direction to input
	gpio_set_pin_direction(RF_GPIO1, GPIO_DIRECTION_IN);

	gpio_set_pin_pull_mode(RF_GPIO1,
	                       // <y> Pull configuration
	                       // <id> pad_pull_config
	                       // <GPIO_PULL_OFF"> Off
	                       // <GPIO_PULL_UP"> Pull-up
	                       // <GPIO_PULL_DOWN"> Pull-down
	                       GPIO_PULL_OFF);

	gpio_set_pin_function(RF_GPIO1, GPIO_PIN_FUNCTION_OFF);

	// GPIO on PA13

	// Set pin direction to input
	gpio_set_pin_direction(RF_GPIO0, GPIO_DIRECTION_IN);

	gpio_set_pin_pull_mode(RF_GPIO0,
	                       // <y> Pull configuration
	                       // <id> pad_pull_config
	                       // <GPIO_PULL_OFF"> Off
	                       // <GPIO_PULL_UP"> Pull-up
	                       // <GPIO_PULL_DOWN"> Pull-down
	                       GPIO_PULL_OFF);

	gpio_set_pin_function(RF_GPIO0, GPIO_PIN_FUNCTION_OFF);

	// GPIO on PA18

	// Set pin direction to input
	gpio_set_pin_direction(GYRO_RDY, GPIO_DIRECTION_IN);

	gpio_set_pin_pull_mode(GYRO_RDY,
	                       // <y> Pull configuration
	                       // <id> pad_pull_config
	                       // <GPIO_PULL_OFF"> Off
	                       // <GPIO_PULL_UP"> Pull-up
	                       // <GPIO_PULL_DOWN"> Pull-down
	                       GPIO_PULL_OFF);

	gpio_set_pin_function(GYRO_RDY, GPIO_PIN_FUNCTION_OFF);

	// GPIO on PA19

	// Set pin direction to input
	gpio_set_pin_direction(ACCL_RDY, GPIO_DIRECTION_IN);

	gpio_set_pin_pull_mode(ACCL_RDY,
	                       // <y> Pull configuration
	                       // <id> pad_pull_config
	                       // <GPIO_PULL_OFF"> Off
	                       // <GPIO_PULL_UP"> Pull-up
	                       // <GPIO_PULL_DOWN"> Pull-down
	                       GPIO_PULL_OFF);

	gpio_set_pin_function(ACCL_RDY, GPIO_PIN_FUNCTION_OFF);

	// GPIO on PA20

	// Set pin direction to input
	gpio_set_pin_direction(HACC_INT2, GPIO_DIRECTION_IN);

	gpio_set_pin_pull_mode(HACC_INT2,
	                       // <y> Pull configuration
	                       // <id> pad_pull_config
	                       // <GPIO_PULL_OFF"> Off
	                       // <GPIO_PULL_UP"> Pull-up
	                       // <GPIO_PULL_DOWN"> Pull-down
	                       GPIO_PULL_OFF);

	gpio_set_pin_function(HACC_INT2, GPIO_PIN_FUNCTION_OFF);

	// GPIO on PA21

	// Set pin direction to input
	gpio_set_pin_direction(HACC_INT1, GPIO_DIRECTION_IN);

	gpio_set_pin_pull_mode(HACC_INT1,
	                       // <y> Pull configuration
	                       // <id> pad_pull_config
	                       // <GPIO_PULL_OFF"> Off
	                       // <GPIO_PULL_UP"> Pull-up
	                       // <GPIO_PULL_DOWN"> Pull-down
	                       GPIO_PULL_OFF);

	gpio_set_pin_function(HACC_INT1, GPIO_PIN_FUNCTION_OFF);

	// GPIO on PB01

	gpio_set_pin_level(MEM_NSEL,
	                   // <y> Initial level
	                   // <id> pad_initial_level
	                   // <false"> Low
	                   // <true"> High
	                   true);

	// Set pin direction to output
	gpio_set_pin_direction(MEM_NSEL, GPIO_DIRECTION_OUT);

	gpio_set_pin_function(MEM_NSEL, GPIO_PIN_FUNCTION_OFF);

	// GPIO on PB10

	// Set pin direction to input
	gpio_set_pin_direction(RF_NIRQ, GPIO_DIRECTION_IN);

	gpio_set_pin_pull_mode(RF_NIRQ,
	                       // <y> Pull configuration
	                       // <id> pad_pull_config
	                       // <GPIO_PULL_OFF"> Off
	                       // <GPIO_PULL_UP"> Pull-up
	                       // <GPIO_PULL_DOWN"> Pull-down
	                       GPIO_PULL_OFF);

	gpio_set_pin_function(RF_NIRQ, GPIO_PIN_FUNCTION_OFF);

	// GPIO on PB11

	gpio_set_pin_level(RF_SHTDN,
	                   // <y> Initial level
	                   // <id> pad_initial_level
	                   // <false"> Low
	                   // <true"> High
	                   true);

	// Set pin direction to output
	gpio_set_pin_direction(RF_SHTDN, GPIO_DIRECTION_OUT);

	gpio_set_pin_function(RF_SHTDN, GPIO_PIN_FUNCTION_OFF);

	// GPIO on PB15

	gpio_set_pin_level(RF_NSEL,
	                   // <y> Initial level
	                   // <id> pad_initial_level
	                   // <false"> Low
	                   // <true"> High
	                   true);

	// Set pin direction to output
	gpio_set_pin_direction(RF_NSEL, GPIO_DIRECTION_OUT);

	gpio_set_pin_function(RF_NSEL, GPIO_PIN_FUNCTION_OFF);

	// GPIO on PB17

	// Set pin direction to input
	gpio_set_pin_direction(MAG_RDY, GPIO_DIRECTION_IN);

	gpio_set_pin_pull_mode(MAG_RDY,
	                       // <y> Pull configuration
	                       // <id> pad_pull_config
	                       // <GPIO_PULL_OFF"> Off
	                       // <GPIO_PULL_UP"> Pull-up
	                       // <GPIO_PULL_DOWN"> Pull-down
	                       GPIO_PULL_OFF);

	gpio_set_pin_function(MAG_RDY, GPIO_PIN_FUNCTION_OFF);

	// GPIO on PB22

	gpio_set_pin_level(LED_RED,
	                   // <y> Initial level
	                   // <id> pad_initial_level
	                   // <false"> Low
	                   // <true"> High
	                   false);

	// Set pin direction to output
	gpio_set_pin_direction(LED_RED, GPIO_DIRECTION_OUT);

	gpio_set_pin_function(LED_RED, GPIO_PIN_FUNCTION_OFF);

	// GPIO on PB23

	gpio_set_pin_level(LED_BLUE,
	                   // <y> Initial level
	                   // <id> pad_initial_level
	                   // <false"> Low
	                   // <true"> High
	                   false);

	// Set pin direction to output
	gpio_set_pin_direction(LED_BLUE, GPIO_DIRECTION_OUT);

	gpio_set_pin_function(LED_BLUE, GPIO_PIN_FUNCTION_OFF);

	ADC_0_init();

	I2C_1_init();
	USART_0_init();

	I2C_0_init();

	SPI_1_init();

	SPI_0_init();

	TARGET_USB_init();
}
