ImperialSpaceSociety/Project-Mach-1/Software/Atmel studio projects/Ricky_Tests/I2C_Scanner/GPS_Passthrough/examples/driver_examples.c

/*
 * Code generated from Atmel Start.
 *
 * This file will be overwritten when reconfiguring your Atmel Start project.
 * Please copy examples or other code you want to keep to a separate file
 * to avoid losing it when reconfiguring.
 */

#include "driver_examples.h"
#include "driver_init.h"
#include "utils.h"

/**
 * Example of using ADC_0 to generate waveform.
 */
void ADC_0_example(void)
{
	uint8_t buffer[2];

	adc_sync_enable_channel(&ADC_0, 0);

	while (1) {
		adc_sync_read_channel(&ADC_0, 0, buffer, 2);
	}
}

void I2C_1_example(void)
{
	struct io_descriptor *I2C_1_io;

	i2c_m_sync_get_io_descriptor(&I2C_1, &I2C_1_io);
	i2c_m_sync_enable(&I2C_1);
	i2c_m_sync_set_slaveaddr(&I2C_1, 0x12, I2C_M_SEVEN);
	io_write(I2C_1_io, (uint8_t *)"Hello World!", 12);
}

/**
 * Example of using USART_0 to write "Hello World" using the IO abstraction.
 *
 * Since the driver is asynchronous we need to use statically allocated memory for string
 * because driver initiates transfer and then returns before the transmission is completed.
 *
 * Once transfer has been completed the tx_cb function will be called.
 */

static uint8_t example_USART_0[12] = "Hello World!";

static void tx_cb_USART_0(const struct usart_async_descriptor *const io_descr)
{
	/* Transfer completed */
}

void USART_0_example(void)
{
	struct io_descriptor *io;

	usart_async_register_callback(&USART_0, USART_ASYNC_TXC_CB, tx_cb_USART_0);
	/*usart_async_register_callback(&USART_0, USART_ASYNC_RXC_CB, rx_cb);
	usart_async_register_callback(&USART_0, USART_ASYNC_ERROR_CB, err_cb);*/
	usart_async_get_io_descriptor(&USART_0, &io);
	usart_async_enable(&USART_0);

	io_write(io, example_USART_0, 12);
}

void I2C_0_example(void)
{
	struct io_descriptor *I2C_0_io;

	i2c_m_sync_get_io_descriptor(&I2C_0, &I2C_0_io);
	i2c_m_sync_enable(&I2C_0);
	i2c_m_sync_set_slaveaddr(&I2C_0, 0x12, I2C_M_SEVEN);
	io_write(I2C_0_io, (uint8_t *)"Hello World!", 12);
}

/**
 * Example of using SPI_1 to write "Hello World" using the IO abstraction.
 */
static uint8_t example_SPI_1[12] = "Hello World!";

void SPI_1_example(void)
{
	struct io_descriptor *io;
	spi_m_sync_get_io_descriptor(&SPI_1, &io);

	spi_m_sync_enable(&SPI_1);
	io_write(io, example_SPI_1, 12);
}

/**
 * Example of using SPI_0 to write "Hello World" using the IO abstraction.
 */
static uint8_t example_SPI_0[12] = "Hello World!";

void SPI_0_example(void)
{
	struct io_descriptor *io;
	spi_m_sync_get_io_descriptor(&SPI_0, &io);

	spi_m_sync_enable(&SPI_0);
	io_write(io, example_SPI_0, 12);
}
