ImperialSpaceSociety/Project-Mach-1/Software/Atmel studio projects/Ricky_Tests/ICSS_OLED/GPS_Passthrough/oled.c

// OLED SSD1315 for Seeed Grove OLED using the I2C interface
// 

#include "atmel_start.h"
#include "atmel_start_pins.h"
#include "OLED.h"

// 8x8 Font ASCII 32 - 127 Implemented
// Users can modify this to support more characters(glyphs)
// BasicFont is placed in code memory.

// This font be freely used without any restriction(It is placed in public domain)
const unsigned char BasicFont[][8] =
{
  {0x00,0x00,0x00,0x00,0x00,0x00,0x00,0x00},
  {0x00,0x00,0x5F,0x00,0x00,0x00,0x00,0x00},
  {0x00,0x00,0x07,0x00,0x07,0x00,0x00,0x00},
  {0x00,0x14,0x7F,0x14,0x7F,0x14,0x00,0x00},
  {0x00,0x24,0x2A,0x7F,0x2A,0x12,0x00,0x00},
  {0x00,0x23,0x13,0x08,0x64,0x62,0x00,0x00},
  {0x00,0x36,0x49,0x55,0x22,0x50,0x00,0x00},
  {0x00,0x00,0x05,0x03,0x00,0x00,0x00,0x00},
  {0x00,0x1C,0x22,0x41,0x00,0x00,0x00,0x00},
  {0x00,0x41,0x22,0x1C,0x00,0x00,0x00,0x00},
  {0x00,0x08,0x2A,0x1C,0x2A,0x08,0x00,0x00},
  {0x00,0x08,0x08,0x3E,0x08,0x08,0x00,0x00},
  {0x00,0xA0,0x60,0x00,0x00,0x00,0x00,0x00},
  {0x00,0x08,0x08,0x08,0x08,0x08,0x00,0x00},
  {0x00,0x60,0x60,0x00,0x00,0x00,0x00,0x00},
  {0x00,0x20,0x10,0x08,0x04,0x02,0x00,0x00},
  {0x00,0x3E,0x51,0x49,0x45,0x3E,0x00,0x00},
  {0x00,0x00,0x42,0x7F,0x40,0x00,0x00,0x00},
  {0x00,0x62,0x51,0x49,0x49,0x46,0x00,0x00},
  {0x00,0x22,0x41,0x49,0x49,0x36,0x00,0x00},
  {0x00,0x18,0x14,0x12,0x7F,0x10,0x00,0x00},
  {0x00,0x27,0x45,0x45,0x45,0x39,0x00,0x00},
  {0x00,0x3C,0x4A,0x49,0x49,0x30,0x00,0x00},
  {0x00,0x01,0x71,0x09,0x05,0x03,0x00,0x00},
  {0x00,0x36,0x49,0x49,0x49,0x36,0x00,0x00},
  {0x00,0x06,0x49,0x49,0x29,0x1E,0x00,0x00},
  {0x00,0x00,0x36,0x36,0x00,0x00,0x00,0x00},
  {0x00,0x00,0xAC,0x6C,0x00,0x00,0x00,0x00},
  {0x00,0x08,0x14,0x22,0x41,0x00,0x00,0x00},
  {0x00,0x14,0x14,0x14,0x14,0x14,0x00,0x00},
  {0x00,0x41,0x22,0x14,0x08,0x00,0x00,0x00},
  {0x00,0x02,0x01,0x51,0x09,0x06,0x00,0x00},
  {0x00,0x32,0x49,0x79,0x41,0x3E,0x00,0x00},
  {0x00,0x7E,0x09,0x09,0x09,0x7E,0x00,0x00},
  {0x00,0x7F,0x49,0x49,0x49,0x36,0x00,0x00},
  {0x00,0x3E,0x41,0x41,0x41,0x22,0x00,0x00},
  {0x00,0x7F,0x41,0x41,0x22,0x1C,0x00,0x00},
  {0x00,0x7F,0x49,0x49,0x49,0x41,0x00,0x00},
  {0x00,0x7F,0x09,0x09,0x09,0x01,0x00,0x00},
  {0x00,0x3E,0x41,0x41,0x51,0x72,0x00,0x00},
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
};


// Initialisation string for SSD1306 OLED display
uint8_t initbuf[]={0x00,0xae,0xa8,0x3f,0xd3,0x00,0x40,0xa1,0xc8,
	0xda,0x12,0x81,0xff,0xa4,0xa6,0xd5,0x80,0x8d,0x14,
0xaf,0x20,0x02};


static unsigned char addressingMode;
struct _i2c_m_msg msg;


void oled_Init(void)

{
    // Send Initialsation string
	msg.addr   = SeeedOLED_Address;
    msg.len    = sizeof(initbuf);
    msg.flags  = I2C_M_STOP;
    msg.buffer = &initbuf[0];
	i2c_m_sync_transfer(&I2C_1, &msg);
   
	
	delay_ms(100);
	oled_SendCommand(SeeedOLED_Display_Off_Cmd);     //display off
    delay_ms(5);
    oled_SendCommand(SeeedOLED_Display_On_Cmd);  //display on
    delay_ms(5);
    oled_SendCommand(SeeedOLED_Normal_Display_Cmd);  //Set Normal Display (default)
}

void oled_SendCommand(unsigned char command)
{
	uint8_t command_bytes[2];
	command_bytes[0] = 0x00;
	command_bytes[1] = command;
	msg.len = 2;
	msg.buffer = &command_bytes[0];
	i2c_m_sync_transfer(&I2C_1, &msg);
}

void oled_Send_2_Command(unsigned char command1, unsigned char command2)
{
	uint8_t command_bytes[3];
	command_bytes[0] = 0x00;
	command_bytes[1] = command1;
	command_bytes[2] = command2;
	msg.len = 3;
	msg.buffer = &command_bytes[0];
	i2c_m_sync_transfer(&I2C_1, &msg);
}

void oled_SetBrightness(unsigned char Brightness)
{
   oled_SendCommand(SeeedOLED_Set_Brightness_Cmd);
   oled_SendCommand(Brightness);
}
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
