ImperialSpaceSociety/Project-Mach-1/(commit log)

2019-08-20 Made the schematics for the Flight computer
    [GPS.sch, MCU.sch, circuit board design.kicad_pcb, circuit board design.sch, power_supply.sch, sensors.sch, telemetry_radio.sch]
2019-08-23 Added documentation and also the references to all components
    [GPS.sch, MCU.sch, circuit board design.sch, partslist.csv, power_supply.sch, sensors.sch, telemetry_radio.sch]
2019-08-24 Got the GPS wired up with the MAX-M8C.
    I wired up the MCU to the GPS as well. Sensors are also wired up to the I2C line.
    TODO:
    -make everything run on 3.3V
    - work out the pyro charges and drivers
    many more.
    [GPS.sch, MCU.sch, circuit board design.sch, power_supply.sch, sensors.sch, telemetry_radio.sch]
2019-08-24 Connected the SPI connection with the SIlabs radio and the XTAL
    [GPS.sch, sensors.sch, telemetry_radio.sch]
2019-08-30 changed boost converter resistor values for 3.3V and more
    -started the pyro drivers
    - connected the SPI connection between radio and MCU
    - boost converter values changed.
    [GPS.sch, MCU.sch, circuit board design.sch, power_supply.sch, pyro_driver.sch, sensors.sch, telemetry_radio.sch]
2019-08-31 Wired up the SI4463 according to AN628 figure 16. Component values have not been set. Only type of component.
    [GPS.sch, circuit board design.sch, telemetry_radio.sch]
2019-08-31 Swapped out the XTAL with a tcxo for radio.
    [MCU.sch, circuit board design.sch, telemetry_radio.sch]
2019-08-31 worked on the silabs 4463 radio chip
    - filled in the component values for TX matching and tx filtering
    - filled in tentative values for RX LNA matching. Will have to verify
    - swapped out XTAL and put in an RS Pro TCXO. Decoupled its powersupply.
    [pyro_driver.sch, telemetry_radio.sch]
2019-09-01 Work in progress for Telemetry Radio
    [circuit board design.sch, pyro_driver.sch, telemetry_radio.sch]
2019-09-01 Change Tx Filter
2019-09-01 Radio Update
    [telemetry_radio.sch]
2019-09-02 Replaced acclerometer with BMI088 6 dof sensor
    -replaced the schematic symbol
    -replaced the footprint. added a local copy
    -wired up the BMI088
    [GPS.sch, sensors.sch]
2019-09-02 changed all the paths for the schematic, footprints to local versions
    so that it will not break when others access from another computer
    [GPS.sch, MCU.sch, sensors.sch]
2019-09-02 changed the SPI flash chip
    -changed to Winbond W74M64FV 64Mbit flash chip to run on 3.3V. Changed schematic symbol and foot print.
    - changed the names of hierarchical labels for the pyros
    [MCU.sch, circuit board design.sch, pyro_driver.sch]
2019-09-02 updated symbol for SPI flash chip on MCU page and added hierachical labels for unconnected pins in MCU
    [MCU.sch]
2019-09-02 Wired the GYRO Ready and ACCL ready interrupt pins
    [MCU.sch, circuit board design.sch, sensors.sch]
2019-09-02 created net list for first time
    -changed SAML21 to J variant7
    -filled in foot prints for all components exept comparator
    -changed the footprints of ICSS pico tracker to a local copy
    [GPS.sch, MCU.sch, circuit board design.sch, pyro_driver.sch, telemetry_radio.sch]
2019-09-04 more upgrades
    - removed the comparators
    - added the cost and link to buy components
    - added in a symbol for USB
    [GPS.sch, MCU.sch, circuit board design.kicad_pcb, power_supply.sch, pyro_driver.sch, sensors.sch, telemetry_radio.sch]
2019-09-04 put in the IIS2MDC magnetometer
    -fixed the error spi connection pins for Flash chip
    [GPS.sch, MCU.sch, circuit board design.sch, pyro_driver.sch, sensors.sch]
2019-09-04 Wired up the FETs
    -fixed the ERC error for the BMI088 symbol
    [MCU.sch, circuit board design.sch, power_supply.sch, pyro_driver.sch, sensors.sch]
2019-09-04 connected 4 channels of pyro drivers
    [GPS.sch, MCU.sch, circuit board design.sch, pyro_driver.sch]
2019-09-04 put in the indicator LEDs
    [MCU.sch]
2019-09-04 moved the USB connector to power_supply schematic
    [MCU.sch, circuit board design.sch, power_supply.sch]
2019-09-04 removed the 37khz crystal
    [GPS.sch, MCU.sch, power_supply.sch, pyro_driver.sch, sensors.sch, telemetry_radio.sch]
2019-09-04 swapped out the MCU from QFN to TQFP
    I suspect I will be making errors and almost certainly will have to jump wires. I think QFN is a nightmare to solder to.
    [MCU.sch]
2019-09-05 fixed errors with symbol and footprint connections
    [MCU.sch, circuit board design.kicad_pcb, power_supply.sch, pyro_driver.sch, sensors.sch]
2019-09-05 added in LDO based power supply
    [MCU.sch, power_supply.sch, pyro_driver.sch, telemetry_radio.sch]
2019-09-05 added screw terminal symbols and anotated power supply page
    [circuit board design.sch, power_supply.sch, pyro_driver.sch]
2019-09-05 set up the PCB to fit formfactor
    [MCU.sch, circuit board design.kicad_pcb, circuit board design.sch, power_supply.sch, pyro_driver.sch]
2019-09-05 Experimenting with arranging components on board. removed matching componets for GPS
2019-09-06 made some attempts to route the board
    -replaced footprint for Radio TCXO
    [MAX (STEP-AP203).STEP, circuit board design.kicad_pcb, telemetry_radio.sch]
2019-09-06 changed the footprint for 220 nH inductor and removed the circuit for low power voltage measurments
    [power_supply.sch, telemetry_radio.sch]
2019-09-06 removed the 100 ohm resistors on the gate of the pyro mosfets
    [pyro_driver.sch]
2019-09-09 added in the foot prints for the 0433BM41A0019 integrated front end for SI4463
    U.FL_Hirose footprint and symbol added in for GPS active antenna
2019-09-09 moved gps antenna coax connection to right page
    [GPS.sch, telemetry_radio.sch]
2019-09-09 added in the RF front end, exactly as stated in AN904
    [GPS.sch, telemetry_radio.sch]
2019-09-09 put in a UFL connector in place of the Active GPS antenna
    [GPS.sch]
2019-09-09 fixed erc problems with Johanson integrated Frontend.
    [GPS.sch, MCU.sch, circuit board design.sch, telemetry_radio.sch]
2019-09-09 added in some comments
    [GPS.sch, MCU.sch, circuit board design.sch, power_supply.sch, pyro_driver.sch, sensors.sch, telemetry_radio.sch]
2019-09-09 completed the pi circuit for Telemetry antenna
    [GPS.sch, telemetry_radio.sch]
2019-09-09 changed the pin header to 2.54mm pitch for programmer and added a 3 pin header for antenna 434
    [MCU.sch, telemetry_radio.sch]
2019-09-09 put in an arming switch
    [MCU.sch, power_supply.sch]
2019-09-09 added pull down resistor to arm switch pin to prevent it from floating and accidentally fireing
    [MCU.sch]
2019-09-11 moved reset pin to programming pin header
    [MCU.sch, circuit board design.kicad_pcb]
2019-09-11 added in comment about where I got the ref layout for GPS+active antenna
    [GPS.sch]
2019-09-11 standardised the symbol for the Johanson RF front end
    [MCU.sch, telemetry_radio.sch]
2019-09-11 Added the USB protection IC
    [MCU.sch, power_supply.sch]
2019-09-12 added the arming switch. Changed foot print of lipo connector to JST
    [MCU.sch, circuit board design.sch, power_supply.sch, pyro_driver.sch, telemetrum partslist.csv]
2019-09-12 updated the datasheet links and sites to purchase
    [circuit board design.kicad_pcb, power_supply.sch, pyro_driver.sch]
2019-09-12 tried routing first round
    [GPS.sch, MCU.sch, sensors.sch, telemetry_radio.sch]
2019-09-12 swapped out the 434 wire antenna for a Yageo434 chip antenna for smaller form factor
    I put in the 3D model for the te connectivity terminal blocks
    [circuit board design.kicad_pcb, pyro_driver.sch, telemetry_radio.sch]
2019-09-12 I put in a 4 terminal block for arming switch
    [circuit board design.kicad_pcb, pyro_driver.sch, telemetry_radio.sch]
2019-09-13 put in the Yageo 434 antenna
    [MCU.sch, circuit board design.kicad_pcb]
2019-09-13 changed the SERCOM ports/pins for SPI flash and radio
    [MCU.sch, circuit board design.sch]
2019-09-13 Did Major reworking of ports
    [MCU.sch, circuit board design.kicad_pcb, circuit board design.sch, power_supply.sch]
2019-09-13 added in the footprint for the 6 terminal block
    routed the RF section with the 434 antenna
    [GPS.sch, MCU.sch, power_supply.sch, pyro_driver.sch, sensors.sch, telemetry_radio.sch]
2019-09-14 Done extensive routing of the board.
    [circuit board design.kicad_pcb, circuit board design.sch, pyro_driver.sch]
2019-09-15 Set up for arming switch
    [circuit board design.kicad_pcb]
2019-09-15 only 2 or 3 connections left to route
    [MCU.sch, circuit board design.kicad_pcb, circuit board design.sch, pyro_driver.sch]
2019-09-15 All connections routed!!
    [circuit board design.kicad_pcb]
2019-09-16 cleaned up redundent overlapping tracks
    also added a 4 header pins for unused mcu pins to the circuit. Not added to board layout yet.
    [MCU.sch, circuit board design.kicad_pcb]
2019-09-16 Put in the Code for the flight computer and drivers.
    [circuit board design.kicad_pcb, telemetry_radio.sch]
2019-09-16 added in molex usb 3D cad and silk screen ICSS logo
    [MCU.sch, circuit board design.kicad_pcb, power_supply.sch, telemetry_radio.sch]
2019-09-16 added links for purchasing some of the parts
    [circuit board design.kicad_pcb, pyro_driver.sch]
2019-09-16 moved the caps out of the courtyard of the accl/gyro sensor
    [circuit board design.kicad_pcb]
2019-09-16 Precisely aligned the mounting holes
    [circuit board design.kicad_pcb]
2019-09-16 done for today
    [MCU.sch, circuit board design.kicad_pcb]
2019-09-17 added in crystal footprint
    [circuit board design.kicad_pcb]
2019-09-17 routed most of the board
    [circuit board design.kicad_pcb]
2019-09-17 Finished routing the board with 3.3V power plane
    Power for mosfets comes from 2mm tracks on top layer. Todo: make their connection to ground more robust
    [GPS.sch, MCU.sch, circuit board design.kicad_pcb]
2019-09-17 updated some of the purchase links
    [circuit board design.kicad_pcb, power_supply.sch]
2019-09-17 added in copper pour to top and bottom layer. Change SPI flash chip
    [circuit board design.kicad_pcb]
2019-09-18 updated the BOM and links and prices
    [MCU.sch, circuit board design.csv, power_supply.sch, telemetry_radio.sch]
2019-09-18 forced to commit
    [circuit board design.kicad_pcb, power_supply.sch]
2019-09-18 more merging conflicts
    [circuit board design.kicad_pcb]
2019-09-18 changed SPI flash chip
    [MCU.sch]
2019-09-18 Flood fill top and bottom layer
    [circuit board design.kicad_pcb]
2019-09-18 updated links to purchasing several components
    [GPS.sch, MCU.sch, circuit board design.kicad_pcb, power_supply.sch, pyro_driver.sch, sensors.sch, telemetry_radio.sch]
2019-09-18 added in excel bill of material. Swapped out SAML for SAMD. They are pin compatible
    [BOM updated.xlsx, MCU.sch, circuit board design.kicad_pcb]
2019-09-22 made a new folder for flight computer v1.1 for the 38mm size minimum diameter rockets
    [BOM updated.xlsx, GPS.sch, MAX (STEP-AP203).STEP, MCU.sch, circuit board design.kicad_pcb, circuit board design.sch, power_supply.sch, pyro_driver.sch]
2019-09-23 put in new acclerometers and 9dof sensor. Changed supplier from mouser to farnell and RS
    [BOM updated.xlsx, BOM v1.1.xlsx, GPS.sch, MCU.sch, circuit board design.sch, power_supply.sch, pyro_driver.sch, sensors.sch]
2019-09-23 wired up the news sensors
    [circuit board design.kicad_pcb, circuit board design.sch, power_supply.sch, pyro_driver.sch, sensors.sch]
2019-09-23 Fully routed board v1.1 with the new high g accelerometer
    [MCU.sch, circuit board design.kicad_pcb, sensors.sch, telemetry_radio.sch]
2019-09-23 flood fill top and bottom layers
    [circuit board design.kicad_pcb]
2019-09-24 put in logo for V1.1
    [GPS.sch, MCU.sch, circuit board design.kicad_pcb, power_supply.sch, pyro_driver.sch, sensors.sch, telemetry_radio.sch]
2019-09-24 connected flood fill of bottom layer to gnd
    [circuit board design.kicad_pcb]
2019-09-24 changed GPS to M8Q and included the diode from V bus to foot print which I missed out
    [GPS.sch, MCU.sch, circuit board design.kicad_pcb, pyro_driver.sch]
2019-09-24 added in grove connector for break out pins. Made a new software framework for SAMD
    [GPS.sch, MCU.sch, circuit board design.kicad_pcb, sensors.sch]
2019-09-24 added 3d model of grove connnector
    [MCU.sch]
2019-09-25 almost done
    [circuit board design.kicad_pcb]
2019-09-25 sent for pcb manufacturing
    [circuit board design.kicad_pcb]
2019-10-01 updated links to purchase
    [sensors.sch, telemetry_radio.sch]
2019-10-02 Create circuit board design v1.1 schematic.pdf
2019-10-02 removed unnecessary files
    [MAX (STEP-AP203).STEP]
2019-10-02 Update circuit board design.pro
2019-10-11 put in the last bom purchase links
    [MCU.sch, pyro_driver.sch, telemetry_radio.sch]
2020-01-21 added in arduino code and board files
    [arduino_zero.cfg, circuit_play.cfg, cricket_m0.cfg, feather_m0.cfg, feather_m0_express.cfg, gemma_m0.cfg, hallowing_m0_express.cfg, itsybitsy_m0.cfg]
2020-01-23 fixed boards.txt, variant.h .Now it can compile
    [variant.h]
2020-01-23 put in some working arduino c files. updated variant.cpp and variant.h.
    I2C and GPS still not working
    [blink.ino, i2c_scanner.ino, serial_gps_passthrough_one_way.ino, variant.cpp, variant.h]
2020-02-06 Got i2c working with changes to variant.cpp and variant.h
2020-02-13 removed unecessary board files
    [arduino_zero.cfg, circuit_play.cfg, cricket_m0.cfg, feather_m0.cfg, feather_m0_express.cfg, gemma_m0.cfg, hallowing_m0_express.cfg, metro_m0.cfg]
2020-02-20 changed spi pin adresses and pads on the bottom of file
2020-02-20 corrected PAD_SPI_TX and PAD_SPI_RX to the correct ones
    [variant.h]
2020-02-21 successfully got SPI to work for FLASH memory
2020-02-21 added in flash diagonostics with correct chip select pin defined
    [Diagnostics_functions.ino, FlashDiagnostics.ino]
2020-02-26 First comit on new branch
    Changed variant files to be more specific to flight computer. Less general purpose Arduino and focuseed on actual hardware. Checked both USb and GPS serial and both wire interfaces.
    ** Note pin numbers have changed**
    [flight_computer_m0.cfg]
2020-02-27 Fixed SPI definitions in Variant.h
    Corrected conflicting and multiple definitions for SPI in varaint.c. Not tested though
    [FlashDiagnostics.ino, variant.cpp, variant.h]
2020-02-27 Create ReadFC_Radio_Info.ino
    Test code to read radio chip information, voltage and temperature
2020-10-27 put in printout of info in main program
2020-10-27 update flash chip in BOM
2020-11-03 adding the msxxx temp+pressure sensor to main loop
2020-11-10 fixed the computer pin
    [variant.h]
2020-11-10 Implement a function to sample the GPS/GNSS sensor
2020-11-10 removed uncessary import of SPI
2020-12-01 adding the data packets, read and print functions
2021-02-16 radio send commands
    fixed sending of gps data in one pulse and added a simple send commands through terminal
    [main_flight_computer_code.ino]
2021-02-16 fix bug with referencing pointer
    [main_flight_computer_code.ino]
2021-02-16 send data only if gnd station mode
2021-02-16 remove duplicated radio config files
    Install it directly from https://github.com/zkemble/Si446x and put in your usual arduino libraries location
    No need to duplicate it here.
2021-02-25 Update variant.cpp
    Corrected pin mapping and ADC channels, all three ADC pins work.
    [variant.cpp]
2021-02-25 Battery level reading
    Created a function reading the voltage level, it also calculates percentage of the battery given min and max voltages
2021-06-17 make blink agnostic of the correct board files
    [blink.ino]
2021-06-17 switch to the J variant
2021-06-17 put in variant files for the rocket flight computer board.
    Platform io will look for this custom files. Importantly, it tracks the variants in version control, and is sharable.
    [flight_computer_m0.cfg]
2021-06-18 move variants files into the boards folder
    [flight_computer_m0.cfg]
2021-06-18 reorganise repo to reduce file name length
    Windows complains that the filename lengths become too long
    [BOM v1.1.xlsx, GPS.sch, MAX (STEP-AP203).STEP, MCU.sch, circuit board design.kicad_pcb, circuit board design.sch, flight_computer_m0.cfg, itsybitsy_m0.cfg]
2021-06-18 switch to the latest sparkfun ublox library
2021-06-18 print format
2021-06-18 put in rtos version
    [flight_computer_m0.cfg]
2021-06-19 set correct power
2021-06-21 set radio power to 10 mW
2021-06-21 downgrade spi memory lib to v3.3
    fixes #16
2021-06-21 switch to using github package
2021-06-21 update to repo with right i2c address
2021-06-22 fixed issue with rubbish data from ms5607
    fixes #19
    [main.cpp]
2021-06-22 specify the silabs pins for our board
    fixes #20
    [main.cpp]
2021-06-22 Integrate RTOS to blink and read sensors on separate threads
2021-06-24 increase sensor thread memory
2021-06-24 remove spi memory
2021-06-25 temporarily disable flash and sensors
2021-06-25 allow sensor read
2021-06-25 printout out percentage and voltage
2021-06-25 move code folder to make filepaths shorter
    [flight_computer_m0.cfg]
2021-06-25 shorter name for folder
    [flight_computer_m0.cfg]
2021-06-25 revert back to using default libraries
    Or the device hangs.
2021-06-25 switch to using SPIFLASHTYPE_W25Q64
2021-06-26 don't put into RX mode
    because the program in the library uses delay microseconds to wait for RX. Holds up every other thread when using delay microseconds
2021-06-26 print debug
2021-06-26 clean up printouts, read sensors
2021-06-26 fix bug in sending
    [telemetry.cpp]
2021-06-26 add more decimal places when printing
2021-06-26 sample every 50 ms
2021-10-04 put in ground station code
    [flight_computer_m0.cfg]
2021-10-04 put in flash dumper
    [flight_computer_m0.cfg]
2021-10-04 put in flash chip deleter
    [flight_computer_m0.cfg]
2021-11-19 new sensors added
2021-11-19 Create Example for libraries reference.sch
    [Example for libraries reference.sch]
2021-11-26 Pyro Driver
2021-11-26 Update Gas sensors ideas.txt
2021-11-27 Moved to proper folder
    [pyro_driver.brd, pyro_driver.sch]
2021-12-09 Pressure sensor additions
2022-02-04 Added sensor schematic and updated pyro driver schematic
    [pyro_driver.sch, sensors.sch]
2022-06-04 New Xbee extension PCB
    [Xbee extension.brd, Xbee extension.sch]
2022-06-04 Changed additional i2c port to serial
    Additional i2c port was changed to serial, to enable new Xbee radio communication
