ImperialSpaceSociety/Project-Mach-1/(notices)

Notices in the files:
Software/Arduino code/main_flight_computer_code/Ublox.cpp:
SparkFun code, firmware, and software is released under the MIT License(http://opensource.org/licenses/MIT).
The MIT License (MIT)
Copyright (c) 2016 SparkFun Electronics
Software/Arduino code/main_flight_computer_code/MS5607.cpp:
arduino-ms5xxx is free software: you can redistribute it and/or modify
it under the terms of the GNU General Public License as published by
the Free Software Foundation, either version 3 of the License, or
(at your option) any later version.
parts and their libraries:
H3LIS100DL: COPYRIGHT: Copyright (C) 2022 Ultra Librarian. All rights reserved.
